Guilleloma/Tamagochi/hardware/case/view_front.png

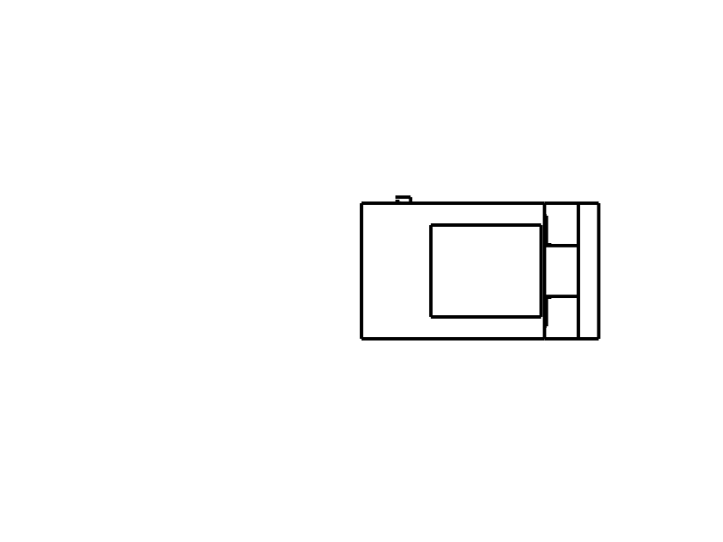
hardware/case/view_front.png
