Guilleloma/Tamagochi/hardware/case/view_isometric.png

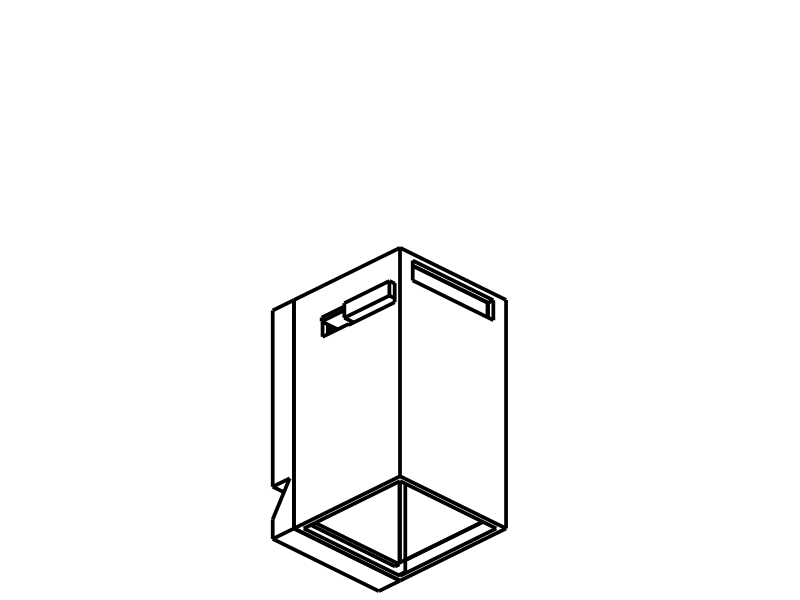
hardware/case/view_isometric.png
