Guilleloma/Tamagochi/hardware/case/view_side_minusX.png

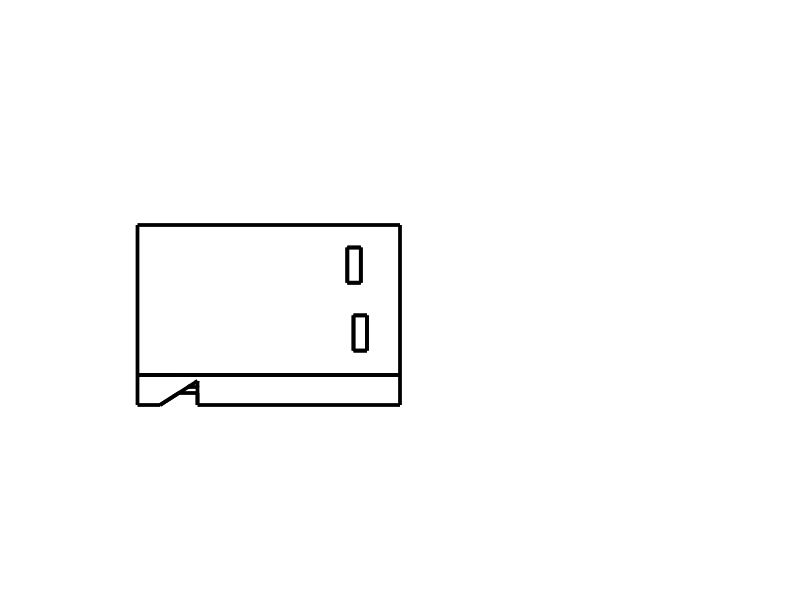
hardware/case/view_side_minusX.png
