Guilleloma/Tamagochi/hardware/case/stl/body-main.stl

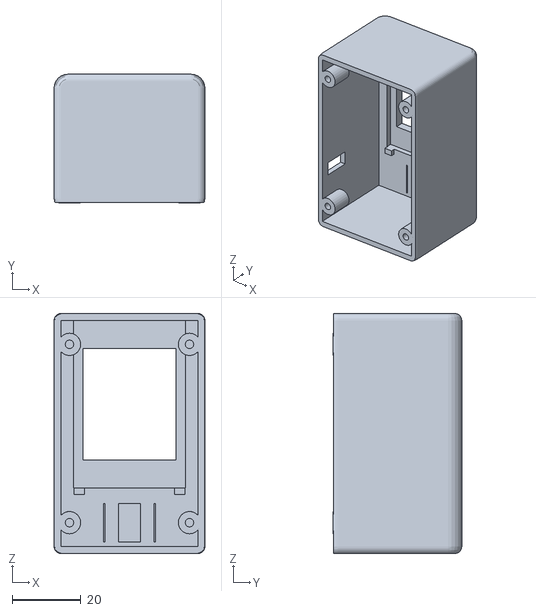
[picture p4: CAD file, 2026-06-21]
hardware/case/stl/body-main.stl
44.0 x 37.5 x 70.0
