Guilleloma/Tamagochi/hardware/case/stl/Tamagotchi.3mf

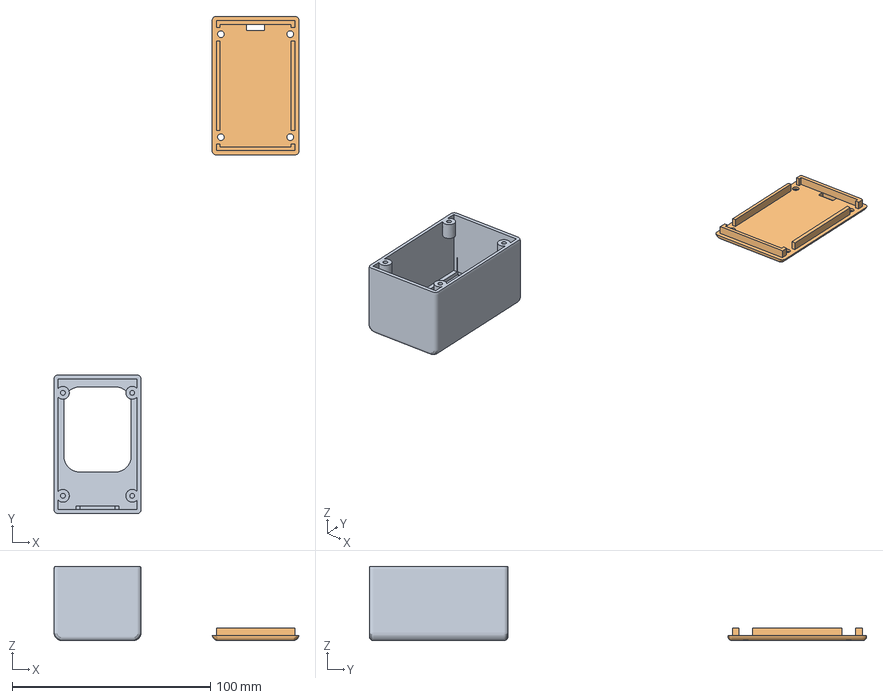
[picture p5: CAD file, 2026-07-13]
hardware/case/stl/Tamagotchi.3mf
123.7 x 251.1 x 37.5 mm
body-main.stl
rear-cover.stl
