Guilleloma/Tamagochi/hardware/case/tamagotchi-case.FCStd

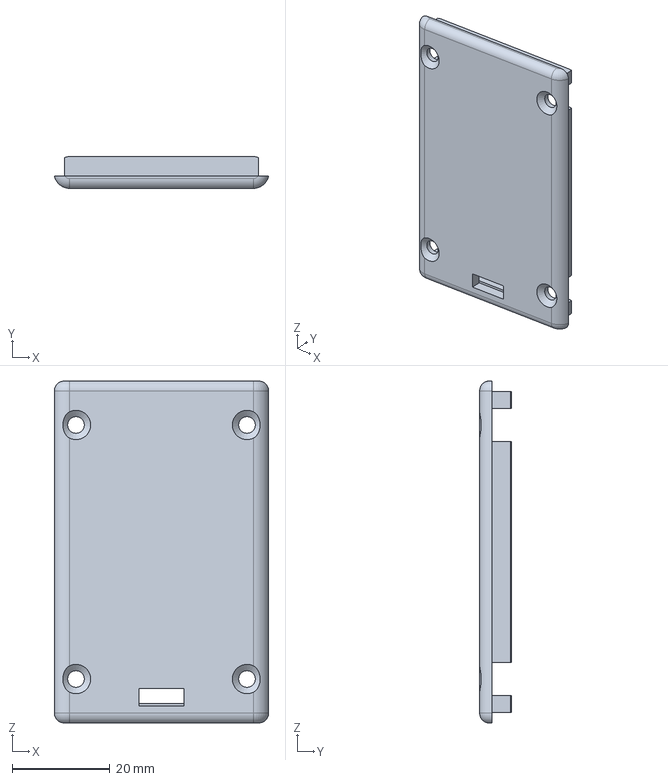
[picture p6: CAD file, 2026-07-13]
hardware/case/tamagotchi-case.FCStd
43.8 x 6.50 x 70.0 mm
