Guilleloma/Tamagochi/(list of files, cad)

Other CAD files:
hardware/case/stl/rear-cover.stl
