Guilleloma/Tamagochi/(commit log)

2026-05-26 Feature: Fase 0 bring-up — OLED + botón GPIO0 + FPS counter
    Scaffolding inicial del firmware Tamagochi para ideaspark ESP8266:
    - PlatformIO env esp12e, framework Arduino, libs U8g2 + OneButton, LittleFS declarado
    - include/config.h con pines OLED (GPIO4/5) y botón (GPIO0) y timings de render
    - src/main.cpp: sketch mínimo con OLED hello, sprite 32x32 animado y log de eventos del botón
    - FPS counter cada 5s para validar budget de render (objetivo >=5 FPS)
    - README con instrucciones de flasheo
    Verificado: pio run OK (RAM 37.3%, Flash 26.9%), pio check sin findings reales.
2026-05-26 Fix: bajar upload_speed a 460800 para CH340G vía hub USB
    El upload a 921600 fallaba con "Invalid head of packet (0xE0)" en setups con
    hub USB intermedio. 460800 es estable y mantiene un upload time razonable
    (~5s para el firmware Fase 0).
    Validado en hardware: flasheo OK, OLED inicializado en GPIO4/5, FPS=5.00 exacto.
2026-05-26 Fix: OLED de ideaspark V3.2 va por SW I2C en GPIO14/12, no HW I2C en GPIO4/5
    La revisión V3.2 de la placa cablea el SSD1306 a GPIO14 (clock) y GPIO12 (data)
    con bit-banging, no a los pines hardware I2C estándar del ESP8266. La guía oficial
    del fabricante lo confirma con el constructor U8G2_SSD1306_128X64_NONAME_F_SW_I2C.
    Síntoma con HW I2C: u8g2.begin() retornaba true (no verifica display real),
    renderFrame() corría a 5 FPS perfectos, pero el OLED mostraba congelado el demo
    de fábrica al no recibir nada por GPIO4/5.
    Cambios:
    - include/config.h: OLED_SDA=12, OLED_SCL=14
    - src/main.cpp: constructor SW_I2C, eliminado Wire.h y Wire.begin()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
    [config.h, main.cpp]
2026-05-26 Docs: actualizar README con resultados verificados de Fase 0 en hardware
    - Pines OLED reales: SW I2C en GPIO12/14 (no HW I2C en GPIO4/5)
    - Upload speed estable confirmado: 460800 baud vía hub USB
    - Estado Fase 0: verificado en hardware el 2026-05-26 con FPS 5.00 estable
    y eventos de botón (click corto + pulsación larga) confirmados por serie
2026-05-26 Docs: planificación Fase 1 + pipeline de sprites
    Artefactos de planificación previos a la implementación:
    - docs/fase-1-plan.md: plan detallado de implementación (StatsEngine,
    EventBus, Logger, Persistence LittleFS rotativa, OTA con password,
    tests host-native, hitos por commits atómicos) — 1215 líneas
    - docs/sprites-plan.md: inventario completo de sprites, layout OLED,
    pipeline PNG → PROGMEM, diferenciación visual entre etapas
    - tools/png_to_xbm.py: convierte PNGs monocromos a arrays C en PROGMEM
    compatibles con U8g2 drawXBMP() (LSB first, XBM estándar)
    - assets/sprites/: carpeta destino para los PNGs (con .gitkeep)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
2026-05-26 Feature: Logger + EventBus — base de Fase 1
    Hito 1 del plan docs/fase-1-plan.md:
    - lib/core/Logger/Logger.h: header-only, macros LOG_ERROR/WARN/INFO/DEBUG con
    LOG_LEVEL configurable (default 3=INFO). Compila para target (Serial.printf)
    y para env native (printf stdout) — base para tests host-native en hito 2
    - lib/core/EventBus/EventBus.{h,cpp}: pub/sub síncrono con function pointers
    planos (no std::function), arrays estáticos sin allocación dinámica,
    kMaxSubscribersPerEvent=4, ~55 bytes RAM. Sin Arduino.h, testeable en host.
    11 EventTypes definidos (button + stats + ota events).
    Build verificado: RAM 37.2% (sin cambio), Flash 26.7% (sin cambio) — Logger es
    header-only y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
2026-05-26 Test: env native con Unity para tests host-native
    Hito 2 del plan docs/fase-1-plan.md:
    - platformio.ini: añadido [env:native] con platform=native, test_framework=unity,
    -std=c++17, -DUNIT_TEST, -DLOG_LEVEL=0. build_src_filter excluye main.cpp y
    módulos dependientes de Arduino (OTAManager, InputHandler, DisplayRenderer,
    LittleFsStorage). [env:esp12e] intacto.
    - test/test_smoke/test_smoke.cpp: smoke test perpetuo que verifica que Unity
    y el entorno native arrancan correctamente. 1 test trivial, ~30 líneas.
    Verificado:
    - pio run -e esp12e: SUCCESS, RAM 37.2%, Flash 26.7% (sin cambio)
    - pio test -e native: 1 Tests 0 Failures 0 Ignored
    Habilita los tests host-native que escribirán l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
2026-05-26 Feature: Persistence LittleFS rotativo con CRC32 + 17 tests host
    Hito 3 del plan docs/fase-1-plan.md (secciones 3.4, 4, 5, 9.2, 9.3).
    Producción:
    - lib/domain/Persistence/Persistence.{h,cpp}: lógica pura (sin Arduino),
    struct PersistedState de 28 bytes con static_assert, CRC32 IEEE table-less,
    load() con escaneo de 4 slots + desempate por lastSavedAtEpoch/ageMinutes,
    save() atómico (escribe → fsync → borra slot k-3), migrate() con política
    de "muerte digna" para versiones incompatibles
    - lib/domain/Persistence/LittleFsStorage.{h,cpp}: IStorage sobre LittleFS,
    guarda #ifndef UNIT_TEST como defensa en profundidad ante cambios de
    build_src_filter
    Tests host (17, todos los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
2026-05-26 Feature: StatsEngine con decay fraccional + 14 tests host
    Hito 4 del plan docs/fase-1-plan.md (secciones 3.3 y 9.2).
    - lib/domain/StatsEngine/StatsEngine.{h,cpp}: lógica pura sin Arduino,
    stats (hunger/happiness/health) con decay fraccional vía acumuladores
    float, clamp a [0,100], dt clampeado a 24h max (evita overflow tras
    meses offline), health decay condicional (solo si hunger>=90 o
    happiness<=10), acumuladores reseteados al aplicar acciones para evitar
    doble descuento, dirty flag para integrar con EventBus.
    Tests host (14, todos los del plan sección 9.2):
    - test/test_stats_engine/test_stats_engine.cpp: defaults, dt=0 noop,
    decay 1s, clamp 0/100, dt huge clam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
2026-05-26 Refactor: extraer DisplayRenderer e InputHandler de main.cpp
    Hito 5 del plan docs/fase-1-plan.md (secciones 3.6 y 3.7).
    Refactor transparente: el comportamiento visible es idéntico a Fase 0
    (mismo texto en OLED, misma animación 32×32, mismos logs serie). Solo
    reorganización del código en preparación para hitos 6-7.
    Módulos nuevos:
    - lib/ui/InputHandler/{h,cpp}: wrapper de OneButton, recibe EventBus por
    constructor pero NO publica eventos aún (TODO(hito-6) documentado).
    Callbacks siguen haciendo Serial.println con los textos de Fase 0.
    - lib/ui/DisplayRenderer/{h,cpp}: renderer con scenes (IdleMain, StatsView,
    OtaProgress). En este hito solo IdleMain implementa el contenido re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
2026-05-26 Feature: EventBus integrado en main + StatsEngine vivo + StatsView real
    Hito 6 del plan docs/fase-1-plan.md (sección 7 — loop principal, parte
    aplicable a hito 6 sin Persistence/OTA).
    Primer hito con comportamiento nuevo visible para el usuario:
    - Click corto → toggle scene IdleMain ↔ StatsView (real, con valores)
    - Pulsación larga (>600ms) → applyFeed(20), hunger baja en tiempo real
    - StatsEngine tickea a 1Hz aplicando decay (visible tras minutos)
    InputHandler.cpp:
    - Callbacks publican al EventBus (ButtonShortClick/Double/LongPress)
    - LOG_INFO con prefijo [BTN] para trazabilidad por serie
    - Eliminados Serial.println literales (reemplazados por Logger)
    - setClickMs(150) + setPres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
2026-05-26 Fix: calibración del botón GPIO0 — click corto responsivo
    Iteración sobre el InputHandler tras hito 6 para resolver:
    - Click corto se sentía lento (~400ms de lag por espera de doble click)
    - Toques rápidos del usuario no se detectaban
    Cambios respecto a d1d3b22:
    - Eliminado attachDoubleClick (el evento ButtonDoubleClick está reservado
    para hitos futuros, ningún handler lo escucha en Fase 1). Sin doble click
    registrado, OneButton dispara attachClick instantáneamente tras soltar.
    - setClickMs reducido a 80ms (era 150ms)
    - setDebounceMs reducido a 40ms (era 75ms inicial intermedio): es el sweet
    spot que captura toques rápidos sin contar rebotes mecánicos del switch
    como cli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
2026-05-26 Feature: sprites Fase 1 (BABY + overlays) generados via Nano Banana
    - 8 loops procesados a 1-bit XBM para OLED 128x64:
    BabyIdle/Happy/Sad/Eat (32x32) + Overlay SleepZ/Hungry/Sick/Poop (16x16)
    - include/sprites_generated.h: 16 arrays PROGMEM, 1472 bytes totales
    - tools/slice_sheet.py: slicer de sprite sheets horizontales con
    trim de marcos perimetrales, flags --single y --preserve-position
    - .gitignore: excluir .venv-tools/ y assets/sprites/raw/ (regenerables)
2026-05-26 Feature: Persistence integrada en main (load al boot, save 5min + on-action)
    - config.h: añade PERSIST_AUTOSAVE_MS (5 min wall-clock, sin escalar con TURBO_MODE)
    - main.cpp: LittleFsStorage + Persistence singletons; helpers fillFromEngine/applyToEngine/loadResultName
    - setup(): monta LittleFS con fallback format, carga slot persistido y aplica al engine
    - loop(): scheduler de autosave cada 5 min vía PersistRequested
    - onLongPress(): publica PersistRequested tras feed (on-action save)
    - onPersistRequested(): serializa estado vivo y escribe en el slot rotativo
    - No se tocó lib/ui/DisplayRenderer/, assets/sprites/ ni sprites_generated.h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
2026-05-26 Feature: bebé BABY visible — sprite escalado, colores invertidos, portrait
    Integración visual del primer sprite real del Tamagochi (BABY idle).
    Validado en hardware con Guillermo: el bebé blanco animado se ve nítido
    ocupando el ancho completo de la pantalla portrait.
    tools/png_to_xbm.py:
    - Nuevo flag --invert que mapea pixel negro → bit=1 (encendido en OLED).
    Necesario porque los PNGs originales vienen con fondo blanco/sujeto negro
    y el OLED rinde el OPUESTO: fondo apagado/sujeto encendido.
    include/sprites_generated.h:
    - Regenerado con --invert: todos los sprites (BABY + overlays) ahora con
    polaridad correcta para el OLED.
    lib/ui/DisplayRenderer/DisplayRenderer.cpp:
    - Elimin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
    [main.cpp]
2026-05-26 Docs: README actualizado para Fase 1 completada
    Hito 9 del plan docs/fase-1-plan.md.
    README.md:
    - Reemplazado estado "Fase 0 (Bring-up)" por tabla de features Fase 1
    - Sección "Cómo se juega" con la mecánica del botón corto/largo + tempo
    - Detalle de hardware actualizado (SW I2C en GPIO12/14, U8G2_R1 portrait)
    - Estructura del proyecto (lib/core/domain/ui)
    - Sección "Verificación de Fase 1" con tests + endurance opcional 24h
    - Roadmap Fase 2-4 + OTA diferido (decisión del usuario)
    include/config.h:
    - Comentario obsoleto "sprite dummy" → "sprite BABY" (los sprites reales
    ya están integrados desde el commit 5d37bb4)
2026-05-26 Docs: plan detallado Fase 2 (1239 líneas, 10 hitos)
    Plan vinculante para backend-expert con la arquitectura completa de Fase 2:
    etapas de vida (EGG→BABY→KID→ADULT→OLD→DEAD), LifeFSM, StatsEngine
    extendido (discipline/weight/poop/sick/sleeping), schema v2 con migrate
    v1→v2, TURBO_MODE con guards anti-producción, animaciones HAPPY/SAD/EAT,
    muerte y resurrección automática.
    Decisiones clave resueltas:
    - Sprites faltantes (no-BABY): BABY como placeholder global, no bloquea
    desarrollo. Sustituciones se hacen por hito intercalado cuando Guillermo
    entregue los PNGs.
    - Schema v2: 40 bytes, migrate v1→v2 con defaults coherentes para los 12
    campos nuevos. Sin romper estados gu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
2026-05-26 Feature: PersistedState v2 — schema 40 bytes + migrate v1→v2
    Hito 1 de Fase 2 (docs/fase-2-plan.md sección 3).
    Persistence:
    - struct PersistedState extendido de 28 → 40 bytes con 12 campos nuevos
    (discipline, weight, poopCount, flags=sick/sleeping, attentionScore,
    deathSustainMs, lastDeathCauseCode, adultType, reservedV2b) + crc32
    movido a offset 36
    - enum LifeStage { Egg=0, Baby=1, Kid=2, Adult=3, Old=4, Dead=5 }
    - kCurrentVersion bumpeada a 2
    - fillDefaults arranca con Egg (huevo nuevo) en lugar de Baby
    - migrate(): dispatch a migrate_v1_to_v2_() según versión leída
    - migrate_v1_to_v2_(): preserva campos v1 (hunger/happ/health/...) y
    rellena los v2 con defaults (discipli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
2026-05-26 Docs: actualizar plan Fase 2 — adultType en lugar de reservedV2
    El byte [33] del PersistedState v2 se usa como adultType (0=normal,
    1=athletic, 2=obese, 3=grumpy) en lugar de reservedV2 (padding).
    La sección 6 del plan ya anticipaba esta decisión; este commit alinea
    la sección 3.1 y 3.3 con la convención adoptada en el hito 1 (331967b).
    Sin cambios funcionales — solo coherencia documental.
2026-05-26 Feature: StatsEngine extendido — discipline/weight/poop/sick/sleeping + 18 tests
    Hito 2 de Fase 2 (docs/fase-2-plan.md sección 4).
    StatsEngine.h:
    - Stats v2 con 5 campos nuevos (discipline=50, weight=50, poopCount=0,
    isSick=false, isSleeping=false, attentionScore=500)
    - DecayRates v2 con 6 ratios nuevos (weight metabolism, discipline,
    poop spawn prob, sickness prob, sick health multiplier)
    - 4 acciones nuevas: applyClean, applyMedicate, applyDiscipline, applySleep
    - resetForNewLife() para huevos nuevos
    - RNG inyectable vía setRandomSource() — function pointer plano, sin
    std::function. Permite tests deterministas con secuencias controladas.
    - kMaxPoopCount = 9
    StatsEngine.cpp:
    -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
2026-05-26 Feature: LifeFSM — 6 etapas de vida + transiciones automáticas + 16 tests
    Hito 3 de Fase 2 (docs/fase-2-plan.md sección 5).
    Nuevo módulo lib/domain/LifeFSM:
    - enum AdultType { Normal=0, Athletic=1, Obese=2, Grumpy=3 }
    - 7 constantes de transición: kEggHatchMin=5, kBabyToKidMin=60,
    kKidToAdultMin=240, kAdultToOldMin=720, kOldToDeadMin=1440,
    kDeathSustainMs=60000, kResurrectionMs=300000
    - tick(dt, stats, attention): consume StatsTick + lee stats const-ref
    para decidir transiciones
    - Egg ignora muerte (huevos no mueren por health)
    - Death sustain con saturating_add a kDeathSustainMs
    - Egg→Baby tras ageMinutes>=5
    - Baby→Kid bloqueada por attentionScore<300, forzada a 1.5×kBabyT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
2026-05-26 Feature: TURBO_MODE — ciclo de vida ×60 para testing
    Hito 4 de Fase 2 (docs/fase-2-plan.md sección 8).
    Permite vivir el ciclo Egg→Baby→Kid→Adult→Old→Dead→Egg completo en
    menos de 1 hora real en lugar de 25h. Solo para desarrollo y QA.
    platformio.ini:
    - Nuevo env esp12e_turbo que extiende esp12e + flags -D TURBO_MODE
    -D TURBO_FACTOR=60. El env por defecto (esp12e) NO lleva TURBO.
    - FIRMWARE_VERSION condicional: 0x0200 (prod) / 0x02FE (turbo).
    El sufijo 0xFE marca "build de desarrollo, no producción".
    - LIFE_FSM_TIME_SCALE: 1 (prod) / TURBO_FACTOR=60 (turbo).
    lib/domain/LifeFSM/LifeFSM.cpp:
    - Fallback inline de LIFE_FSM_TIME_SCALE (sin incluir config.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
2026-05-26 Feature: DisplayRenderer multi-sprite por etapa + DeadScreen + banner TURBO
    Hito 5 de Fase 2 (docs/fase-2-plan.md sección 6).
    DisplayRenderer.h:
    - enum class Mood { Idle, Happy, Sad, Eat }
    - Scene::DeadScreen añadida
    - API nueva: setLifeStage, setAdultType, setLastDeathCause,
    setAgeMinutes, setDeathCount, triggerEatAnimation
    - Privados: lifeStage_, adultType_, lastDeathCause_, ageMinutes_,
    deathCount_, eatAnimRemainingMs_, computeMood_(), drawDeadScreen_(),
    drawTurboBanner_() bajo #ifdef TURBO_MODE
    DisplayRenderer.cpp:
    - struct SpriteFrames { frames[3], frameCount } para centralizar
    animaciones de 1, 2 o 3 frames
    - Tabla kSpritesByStage[6][4] (LifeStage x Mood): fila BABY con
    s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
2026-05-26 Feature: overlays asíncronos sobre sprite — sleep/sick/hungry/poop
    Hito 6 de Fase 2 (docs/fase-2-plan.md sección 6.4).
    DisplayRenderer.cpp añade drawOverlays_() llamado desde drawIdleMain_
    justo antes de sendBuffer(). Pinta encima del sprite del personaje
    según el estado vivo de stats_:
    - Sick (calavera 16x16 en x=4, y=4): cuando isSick=true
    - SleepingZ (animado 800ms): cuando isSleeping. Posición x=42 normal,
    se desplaza a x=24 si Sick también está activo (evita solape).
    - Hungry (gota parpadeante 600ms): cuando hunger>=80 && !isSleeping.
    En x=48, y=68 (debajo del sprite, esquina derecha).
    - Poop (caca 16x16, hasta 3 visibles): cuando poopCount>0. En y=110
    (zona inferior li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
2026-05-27 Feature: cablear LifeFSM + DeadScreen + EAT animation en main (hitos 7-9)
    Integración completa de Fase 2 en src/main.cpp. Fusiona los hitos 7
    (muerte y resurrección), 8 (animación EAT one-shot) y 9 (cableado
    LifeFSM + persist en transiciones) en un commit coherente porque
    todos modifican el mismo archivo y dependen entre sí.
    Singletons nuevos:
    - LifeFSM lifeFSM(bus) construido tras StatsEngine
    - previousStage_ static para detectar resurrección Dead → Egg
    Helpers actualizados a schema v2:
    - applyToStatsEngine reemplaza applyToEngine: lee todos los 9 campos
    v2 desde PersistedState (incluye discipline, weight, poopCount, flags
    bit-packed, attentionScore)
    - fillFromEngine ahora toma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
2026-05-27 Polish: mini-contador edad + ortografía "Tamagotchi"
    Pulido visual de Fase 2 tras validación en hardware con Guillermo.
    - Mini-contador de edad debajo del título en IdleMain. Formato compacto:
    "9m" si <60 min, "1h2m" si >=60 min, cap a 99h para caber en 64px.
    Fuente 6x10 (igual que título) por legibilidad — el 4x6 inicial era
    ilegible en hardware según feedback. Posición (0, 100) bajo "Tamagotchi"
    en y=85, sin solape.
    - Fix ortografía: "Tamagochi" → "Tamagotchi" (marca correcta, con T).
    10 chars × 6 px = 60 px, recentrado en x=2 (cabe justo en 64 wide).
    src/main.cpp:
    - Tras lifeFSM.tick() en cada stats tick, llamada a
    renderer.setAgeMinutes(life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
    [main.cpp]
2026-05-27 Docs: README actualizado para Fase 2 completada
    Hito 10 del plan docs/fase-2-plan.md.
    - Título corregido "Tamagochi" → "Tamagotchi" (marca con T)
    - Descripción actualizada con ciclo de vida completo
    - Sección "Cómo se juega" extendida: 6 etapas, animaciones, overlays
    asíncronos, mini-contador edad, DeadScreen, resurrección
    - Tabla de estado por capa con 13 features verificadas + 4 diferidas
    - Comandos PlatformIO incluyen env esp12e_turbo
    - Estructura del proyecto refleja LifeFSM y tests v2
    - Sección "Verificación de Fase 2" con tests + endurance opcional
    - Pipeline de sprites documentado (slice_sheet.py + png_to_xbm.py --invert)
    - Roadmap actualizado: Fase 2.5 (sprite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
2026-05-27 Assets+Feature: sprites EGG (4 frames) generados e integrados
    Primer batch de sprites no-BABY de Fase 2.5. El huevo es ahora visible
    en pantalla cuando lifeStage_ == Egg (al primer boot sin estado guardado,
    o tras resurrección Dead → Egg).
    assets/sprites/egg_0..3.png:
    - Generados por el otro dev con Nano Banana + slice_sheet.py
    - 4 frames: quieto, leve vibración, vibración fuerte, grieta
    - 32×32 monocromo, fondo blanco / sujeto negro
    - Regenerado con tools/png_to_xbm.py --invert
    - Añadidos kSpriteEgg0..3 (32x32 cada uno, 128 bytes PROGMEM × 4 = 512B)
    - kSpritesByStage[Egg][] ya no usa kSpriteBabyIdle como pla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
2026-05-27 Feature: animaciones de transición + tabla Egg sin moods + fix colores
    Pulido visual tras validación con Guillermo del primer ciclo de vida.
    DisplayRenderer:
    - triggerHatchAnimation() one-shot 2.4s: cuando Egg→Baby, muestra
    frames 2-3 del huevo (vibración + grieta) con texto "Eclosion"
    antes de revelar el bebé. Visualiza la eclosión.
    - triggerEvolveAnimation() one-shot 1.2s: cuando Baby→Kid, Kid→Adult,
    Adult→Old, parpadea el sprite (alterna visible/oculto cada 200ms)
    para señalar el cambio de etapa.
    - Tabla kSpritesByStage[Egg]: todos los moods usan frames 0+1 idle
    (el huevo no tiene moods narrativos). Frames 2-3 reservados para
    la animación de eclosión.
    - Forwar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
    [main.cpp]
2026-05-27 Assets+Feature: sprites KID/ADULT/OLD/DEAD integrados
    Resto de etapas de vida con arte real. Genera el ciclo visual completo
    del Tamagotchi clásico: Egg → Baby → Kid → Adult → Old → Dead → Egg.
    Sprites nuevos (16 PNGs en assets/sprites/):
    - kid_idle_0/1 + kid_happy_0/1/2 + kid_sad_0/1
    - adult_idle_0/1 + adult_happy_0/1/2
    - old_idle_0/1
    - dead_ghost_0/1
    - Nuevos arrays: kSpriteKidIdle0/1, kSpriteKidHappy0/1/2, kSpriteKidSad0/1,
    kSpriteAdultIdle0/1, kSpriteAdultHappy0/1/2, kSpriteOldIdle0/1,
    kSpriteDeadGhost0/1
    lib/ui/DisplayRenderer/DisplayRenderer.cpp tabla kSpritesByStage:
    - Kid (2): idle/happy/sa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
2026-05-27 Assets+Feature: sprites EAT para Kid/Adult/Old (9 PNGs, 3 frames cada uno)
    Cada etapa de vida tiene ahora su propia animación de comer.
    Antes, todas las etapas no-Baby usaban fallback idle al alimentar
    (long press en hardware) — visualmente no había diferencia.
    Assets nuevos:
    - kid_eat_0/1/2.png (niño comiendo, 3 frames)
    - adult_eat_0/1/2.png (adulto comiendo, 3 frames)
    - old_eat_0/1/2.png (anciano comiendo, 3 frames)
    include/sprites_generated.h regenerado con --invert:
    - kSpriteKidEat0/1/2, kSpriteAdultEat0/1/2, kSpriteOldEat0/1/2
    - Kid[Eat] → kSpriteKidEat0/1/2 (era fallback kSpriteKidIdle)
    - Adult[Eat] → kSpri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
2026-05-27 Docs: cierre Fase 2.5 — sprites completos + backlog claro
    - Fase 2.5 marcada como completada en el roadmap
    - Backlog específico para no perder pendientes:
    · applyPlay (única acción Tamagotchi clásico no implementada)
    · ActionMenu en pantalla (navegación con 1 botón)
    · Sprites faltantes Adult sad, Old happy/sad (baja prioridad)
    · AdultType variants (athletic/obese/grumpy)
    - Mención explícita "jugar" en Fase 3 (web UI) además de limpiar/curar/etc
    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
2026-05-27 Feature: applyPlay con coste energético + guard isSleeping
    La acción "jugar" ya existía pero era minimalista (solo subía happiness,
    sin coste, sin restricciones). Ampliada para reflejar la mecánica del
    Tamagotchi clásico:
    - Coste energético: hunger += amount/2 al jugar (jugar quema energía
    y abre el apetito). applyPlay(20) sube happiness +20 Y hunger +10.
    - Guard isSleeping: si el Tamagotchi está dormido, applyPlay es no-op
    con LOG_DEBUG. Consistente con applyFeed.
    - Acumuladores hungerAcc_ y happinessAcc_ reseteados para evitar doble
    descuento en el siguiente tick.
    Tests nuevos (2, total 73):
    - test_play_also_increases_hunger: verifica que play(20) sube hunger
    en 10 adem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
2026-05-27 Docs: plan detallado Fase 3 (1300 líneas, 9 hitos)
    Plan vinculante para backend-expert con la arquitectura completa de
    la Web UI WiFi: AsyncWebServer + REST /api/v1/* + HTML/CSS/JS desde
    LittleFS + WiFi STA con secrets.h gitignored + OTA con password + auth
    básica + rate limiting + indicador WiFi en OLED.
    Decisiones críticas resueltas:
    - ESPAsyncWebServer (async, no bloquea loop) vs sync
    - secrets.h gitignored extendido (WIFI_SSID/PASSWORD + WEB_AUTH_USER/PASS
    + OTA_HOSTNAME/PASSWORD)
    - WiFi degradación graceful: 0ms bloqueo setup, reintentos background
    - HTTP Basic Auth (no OAuth) sobre LAN trust
    - Rate limit token bucket 10/600ms, 4 IPs LRU
    - ArduinoJson v7 con JsonDocument en stack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
2026-05-27 Feature: WifiManager + secrets.h gitignored + indicador WiFi en OLED
    Hito 1 de Fase 3 (docs/fase-3-plan.md sección 1-2, 6, 7).
    Infraestructura WiFi mínima sin bloquear el loop:
    include/secrets.h.example (versionado):
    - Template con WIFI_SSID/PASSWORD, OTA_HOSTNAME/PASSWORD,
    WEB_AUTH_USER/PASSWORD. Strings vacíos = feature deshabilitada.
    - El usuario copia a include/secrets.h (gitignored) y rellena.
    .gitignore:
    - Añadida línea explícita "include/secrets.h" para garantizar que
    el archivo con credenciales reales nunca se commitee.
    lib/infra/WifiManager/:
    - Estados: Disabled (SSID vacío), Connecting, Connected, Disconnected
    - begin() no bloquea — sólo llama WiFi.begin() y arran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
2026-05-27 Feature: OTAManager + mDNS + env esp12e_ota para flasheo por aire
    Hito 2 de Fase 3 (docs/fase-3-plan.md sección 8).
    El firmware ya se puede actualizar SIN cable USB desde el Mac.
    lib/infra/OTAManager/:
    - Singleton-via-instance para callbacks C de ArduinoOTA (mismo patrón
    que InputHandler con OneButton). Evita std::function overhead.
    - begin() solo arranca si OTA_PASSWORD no está vacío. Si vacío, LOG_WARN
    y queda en estado "no ready" sin error.
    - Hostname y port (8266) desde secrets.h
    - Callbacks publican OtaStarted/OtaProgress/OtaEnded/OtaError al bus
    - end() solo desmarca ready_ (ArduinoOTA.end() no existe en el SDK)
    lib/core/EventBus/EventBus.h:
    - OtaFinished renombrado a OtaEn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
    [main.cpp]
2026-05-27 Feature: JsonCodec + PayloadValidator + 20 tests host
    Hito 3 de Fase 3 (docs/fase-3-plan.md secciones 4 y 9.1-9.2).
    Capas puras de serialización/validación, sin Arduino.h, testeables
    en host-native con Unity. Preparan el terreno para los endpoints
    REST que añadirá el hito 5.
    lib/infra/WebUI/JsonCodec.{h,cpp}:
    - Namespace JsonCodec (no clase) con funciones libres
    - serializeState(stats, stage, ageMin, deathCount, turbo, out, outSize)
    → {data: {...}, meta: {apiVersion, timestamp}}
    - serializeInfo(version, uptime, freeHeap, rssi, out, outSize)
    - serializeActionResponse(...) con actionApplied
    - serializeError(code, message, out, outSize) — formato estándar
    {error: {code, message}}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
2026-05-27 Feature: RateLimiter + AuthChecker + 15 tests host
    Hito 4 de Fase 3 (docs/fase-3-plan.md secciones 1.5, 1.6, 9.3, 9.4).
    Capas puras de seguridad y throttling para los endpoints REST.
    Ambas testeables en host-native sin Arduino.h.
    lib/infra/WebUI/RateLimiter.{h,cpp}:
    - Token bucket por IP, capacidad 10 tokens, refill 1/600ms
    - Array fijo IpBucket[kMaxTrackedClients=4], sin malloc
    - LRU eviction cuando se acuserve un 5º IP — slot más antiguo se reasigna
    - allow(clientIp, nowMs) → true si permite, false si rate-limited
    - Tiempo inyectado vía parámetro nowMs (no llama millis() — testeable)
    - Refill drift-free: lastRefillMs += addTokens × interval (no reset a now)
    - Defensive contra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
2026-05-27 Fix: invertir polaridad de sprites OLED (silueta ON, fondo OFF)
    Los PNGs en assets/sprites/ se dibujan con fondo blanco + silueta negra,
    pero el generador png_to_xbm.py mapeaba "pixel blanco -> bit=1 (ON)" por
    defecto, lo que dejaba el FONDO encendido y la silueta apagada en el OLED
    SSD1306. En la placa se veía la silueta oscura sobre fondo claro.
    - tools/png_to_xbm.py: invertir el default. Ahora "pixel negro -> bit=1".
    El flag pasa de --invert a --raw para el caso opuesto (PNGs ya en
    convencion XBM estandar). Docstring actualizado.
    - include/sprites_generated.h: regenerado entero con la nueva polaridad
    (silueta encendida, fondo apagado). Afecta a sprites de personaje
    (32x32) y ove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
2026-05-27 Feature: WebUI AsyncWebServer + GET /api/v1/state e /info
    Hito 5 de Fase 3 (docs/fase-3-plan.md secciones 3.1-3.2, 4.1-4.4, 4.6).
    Primera versión funcional del servidor HTTP del Tamagochi.
    Validado en hardware: curl -u admin:xxx http://tamagotchi.local/api/v1/state
    devuelve JSON 200 con todos los stats; auth incorrecta → 401.
    lib/infra/WebUI/WebUI.{h,cpp}:
    - Clase WebUI con AsyncWebServer en puerto 80
    - Constructor toma const refs a EventBus, StatsEngine, LifeFSM, WifiManager
    (solo lectura; no llama directamente al dominio, futuras acciones
    pasarán por EventBus en hito 6)
    - begin()/end() idempotentes; arrancar solo con WiFi conectado
    - mountRoutes_(): registra GET /api/v1/state, GE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
2026-05-27 Feature: 7 endpoints POST para acciones del Tamagochi vía REST
    Hito 6 de Fase 3 (docs/fase-3-plan.md secciones 4.3-4.5, 4.7).
    Por primera vez el móvil puede EJECUTAR acciones del Tamagochi vía
    HTTP. Antes solo se podía leer (GET); ahora se puede actuar (POST).
    - 7 EventType nuevos (antes de EventTypeCount):
    ActionFeedRequested, ActionPlayRequested, ActionHealRequested,
    ActionCleanRequested, ActionMedicateRequested,
    ActionDisciplineRequested, ActionSleepRequested
    - Payload semántica: amount (1-100) para feed/play/heal/discipline,
    0 para clean/medicate, 0/1 para sleep off/on
    lib/infra/WebUI/{h,cpp}:
    - 7 handlers privados (5 con JsonVariant body, 2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
2026-05-27 Feature: frontend HTML/CSS/JS en data/ + serveStatic en WebUI
    Hito 7 de Fase 3 (docs/fase-3-plan.md sección 5).
    El móvil ya tiene una UI completa para gestionar el Tamagotchi sin
    curl. Tras flashear firmware + subir LittleFS, abrir
    http://tamagotchi.local desde cualquier navegador en la LAN.
    data/index.html (~3.6 KB):
    - Layout mobile-first portrait, HTML5 semántico
    - Header: título "Tamagotchi" + badge Online/Offline
    - Sección mascota: emoji grande según lifeStage (🥚🐣👶👦🧑👴💀)
    con bounce CSS sutil, stage + edad
    - Badges inline: 🤧 Sick (rojo) y 💤 Sleeping (azul) cuando aplique
    - Stats: 4 barras de progreso (Hambre, Animo, Salud, Disciplina)
    + Peso/Caca deba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
2026-05-27 Test: script integracion HTTP scripts/integration_test.sh (27 tests)
    Hito 8 Fase 3: valida los 9 endpoints REST + frontend estatico contra
    un dispositivo real. Cubre auth (401), happy path por endpoint, errores
    de validacion (422), JSON malformado (400) y 404. Sin dependencias mas
    alla de curl + bash.
    Uso:
    HOST=192.168.x.x ./scripts/integration_test.sh
    HOST=tamagotchi.local ./scripts/integration_test.sh
    Resultado actual contra placa: 27 PASS / 0 FAIL.
2026-05-27 Docs: README actualizado a Fase 3 completada
    - Tabla "Estado actual" refleja WifiManager / OTAManager / WebUI /
    RateLimiter / AuthChecker / frontend LittleFS.
    - Test count actualizado de 71 a 108 host + 27 integracion HTTP.
    - Nueva seccion "Web UI - Fase 3" con tabla de endpoints, auth, rate
    limiting y como correr scripts/integration_test.sh.
    - Setup incluye uploadfs y flasheo OTA (env esp12e_ota).
    - Seccion "Secrets" documenta los campos de include/secrets.h y el
    comportamiento si quedan vacios.
    - Roadmap: Fase 3 marcada, Fase 4 sigue pendiente. Backlog actualizado
    (applyPlay eliminado — ya mergeado en main; reset y cosmetico sleep
    documentados).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
2026-05-27 Refactor: HUD top en IdleMain (edad izq, estado rotante, wifi der)
    El layout anterior repartía info por toda la pantalla: texto "Tamagotchi"
    debajo del sprite, edad en la esquina inf-izq, overlays sick/sleep/hungry/
    poop dispersos arriba y abajo. Quedaba abigarrado y sin zona libre para
    las acciones que llegan en próximas fases.
    Nuevo layout (64x128 portrait):
    HUD top (y=0..15): edad izq | estado rotante 16x16 centro | wifi der
    Personaje (y=16..79): sprite 32x32 escalado x2 -> 64x64
    Zona inferior (y=80..127, 48 px): libre para acciones futuras
    Cambios concretos:
    - drawIdleMain_: elimina texto "Tamagotchi", elimina edad inferior,
    sube sprite de y=4 a y=16, pinta edad arriba-izq en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
2026-05-27 Feature: ActionKind + listAvailableActions con precondiciones
    Introduce el enum ActionKind y la función listAvailableActions en
    StatsEngine para que la capa de UI pueda consultar qué acciones físicas
    están disponibles según el estado actual del Tamagochi, sin acoplar
    lógica de negocio al dispatcher ni al renderer. El dispositivo deja de
    ser subordinado pasivo del dashboard: tiene su propia lógica de qué
    acciones son válidas en cada momento.
2026-05-27 Feature: menú físico de acciones + StatsView densa (paridad físico/dashboard)
    Añade Scene::ActionsMenu al DisplayRenderer con cursor navegable,
    drawActionsMenu_ para renderizar la lista filtrada por precondiciones,
    y StatsView densa con 9 stats en pantalla. Refactoriza onShortClick y
    onLongPress en main.cpp con lógica contextual y helpers quickFeed_ /
    executeSelectedAction_. El dispositivo físico alcanza paridad funcional
    con el dashboard: el usuario puede ejecutar cualquier acción directamente
    desde los botones, sin depender de la interfaz web.
2026-05-27 Refactor: HUD inferior de acciones en IdleMain (sustituye ActionsMenu)
    El menú separado de acciones obligaba a abandonar la pantalla principal
    para seleccionar qué hacer, perdiendo de vista al bicho. Ahora el sprite
    y la acción seleccionada conviven en IdleMain: short click cicla la
    acción en el HUD, long press la ejecuta. Se elimina Scene::ActionsMenu
    y todo su renderizado asociado. ActionKind::Back pasa a ActionKind::Stats
    para reflejar su propósito real. La vista de stats recupera el foco con
    un simple short click desde ella.
    [main.cpp]
2026-05-27 Feature: iconos 16x16 en HUD inferior de acciones
    - Sustituye dots de paginacion + hint "long=OK" por icono pixel-art 16x16 por accion + label centrado.
    - Iconos generados con tools/generate_action_icons.py (pictogramas placeholder; sustituibles por arte definitivo).
    - 8 sprites nuevos: feed, play, clean, medicate, discipline, sleep, heal, stats.
    - Coste flash: +256 bytes (8 x 32 bytes XBM). Build OK, RAM 48.7%, Flash 41.3%.
2026-05-27 Feature: frames de animacion para acciones (Play/Clean/Disc/Heal)
    10 PNGs 16x16 monocromos generados por dev externo:
    - Play: 4 frames (action_play_0..3)
    - Clean: 2 frames (action_clean_0..1)
    - Discipline: 2 frames (action_discipline_0..1)
    - Heal: 2 frames (action_heal_0..1)
    Header sprites_generated.h regenerado con todas las constantes XBM nuevas.
2026-05-27 Feature: HUD horizontal compacto + sprite centrado + animaciones de accion
    - HUD inferior rediseñado en 1 fila (y=112..127): icono 16x16 + label 6x10
    en horizontal, liberando aire vertical respecto al layout anterior
    - Sprite del personaje centrado en y=32, con 16px de margen arriba y abajo
    entre el HUD superior y el HUD inferior
    - Nuevo mecanismo de animacion de sustitucion: drawXBMx4 renderiza frames
    ampliados x4, triggerActionAnimation reemplaza al sprite del muneco durante
    600ms x frameCount (1.2s Play/Clean/Disc/Heal con 2-4 frames)
    - Conectado en executeSelectedAction_ para Play, Clean, Discipline y Heal;
    Feed mantiene su animacion EAT clasica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
2026-05-27 Feature: sustituye boton FLASH por touch TTP223 en GPIO4
    PIN_BUTTON pasa de GPIO0 (FLASH onboard active-LOW con pull-up) a GPIO4
    (sensor capacitivo TTP223 active-HIGH push-pull). Se extiende la API de
    InputHandler con un nuevo parametro pullupActive (default true para no
    romper la firma existente) y se propaga al constructor de OneButton.
    La instanciacion en main.cpp pasa activeLow=false y pullupActive=false
    para reflejar la salida limpia del TTP223. Los timings de OneButton
    (click 80ms, debounce 40ms, longpress 600ms) se mantienen idénticos —
    los eventos publicados al EventBus son los mismos, sin cambios en la FSM.
2026-05-27 Docs: actualiza README con touch TTP223 como input principal
    La tabla de hardware refleja el TTP223 en GPIO4 (D2) en lugar del FLASH
    en GPIO0. Se reescribe la nota sobre comportamiento del boton: ya no hay
    rebote mecanico que justifique el rango 100-500 ms — el TTP223 entrega
    flanco limpio, asi que la nota describe directamente los umbrales de
    click corto vs. long press y el LED visual del modulo.
2026-05-27 Refactor: baja debounce del boton a 10 ms tras pasar a touch capacitivo
    El debounce de 40 ms era una concesion al rebote mecanico del FLASH onboard.
    El TTP223 entrega flanco limpio: 10 ms ya filtra cualquier ruido residual y
    reduce a la mitad la latencia percibida del click corto. setClickMs baja a
    30 ms por coherencia (sigue sin efecto practico al no haber doubleClick
    attach). setPressMs se mantiene en 600 ms — el umbral de long press no
    viene marcado por hardware sino por la intencion del usuario.
2026-06-18 Feature: ESP32-S3 env + JD9853 color display bring-up y SpriteStore (Fases 0-1)
    - platformio.ini: nuevo env esp32s3 con lib_deps (TFT_eSPI, LittleFS) y lib_ignore
    - src/bringup_esp32s3.cpp: sketch de bring-up, integración SpriteStore y canvas
    - lib/ui/SpriteStore/SpriteStore.h y .cpp: loader de sprites RGB565 desde LittleFS
2026-06-18 Feature: add wizard RGB565 sprite assets para LittleFS
    - data/sprites/manifest.json: índice de animaciones del mago
    - data/sprites/wiz/{eat,happy,playing,sick,sleep,walk}/*.bin: frames RGB565
    para carga directa en LittleFS del ESP32-S3
2026-06-18 Feature: extraer WifiState enum y definir DisplayRendererColor API (Fase 2)
    - lib/core/WifiState.h: enum WifiState extraído de WifiManager para romper dependencia circular
    - lib/infra/WifiManager/WifiManager.h: incluye WifiState.h en lugar de definir el enum inline
    - lib/ui/DisplayRendererColor/DisplayRendererColor.h: interfaz pública del renderer color para ESP32-S3 (TFT 240x280, paleta 16-bit)
2026-06-18 Feature: implementar DisplayRendererColor para TFT color ESP32-S3 (Fase 2)
    Implementación completa del renderer color: inicialización TFT via LGFX,
    doble buffer en PSRAM, renderizado de sprites monocromo con paleta de color,
    overlays de UI (barra de vida, indicadores de estado, menú), y primitivas
    de debug. Sustituye al DisplayRenderer monocromo de la placa original.
2026-06-18 Feature: loop de juego ESP32-S3 con panel JD9853, input y persistencia (Fases 3-4)
    - include/jd9853_panel.h: configuración compartida del panel TFT JD9853 (init cmds, timings)
    - src/main_esp32.cpp: entrypoint de producción ESP32-S3 con game loop real, input buttons,
    NVS persistence y watchdog
    - src/main_phase2.cpp: harness de desarrollo Fases 2-3 para validar renderer y WiFi por separado
    - include/config.h: botón GPIO condicional por plataforma + FIRMWARE_VERSION para ESP32-S3
    - platformio.ini: envs esp32s3 / esp32s3_turbo, lib_deps LGFX, build_src_filter por env
2026-06-19 Feature: catalogo de sprites Furbygotchi por etapa (egg/baby/kid/adult/old/ghost) en LittleFS
    Reemplaza el set wiz/ por 6 etapas de vida con sus animaciones .bin:
    egg(2), baby(23), kid(23), adult(23), old(23), ghost(6). Actualiza manifest.json.
2026-06-19 Feature: DisplayRenderer multi-etapa con precarga en PSRAM (Fase 6)
    Refactor a struct StageSprites y spritesByStage_; framesForMood_(stage,mood)
    resuelve frames por etapa/estado. Precarga de las 6 etapas en PSRAM al inicio.
    drawDeadScreen usa sprites ghost.
2026-06-19 Feature: animaciones one-shot de accion + render a 15 FPS (pulido Fase 6)
2026-06-19 Feature: WiFi + OTA + WebUI dashboard en ESP32-S3 (Fase 5)
2026-06-19 Refactor: eliminar harnesses de desarrollo (bringup, main_phase2) para main estable
2026-06-19 Docs: documentar variante ESP32-S3 color (Furbygotchi) en README
2026-06-19 Fix: limpiar GRAM muerto del panel JD9853 (ruido borde superior)
    El panel nativo es 240x320 pero el canvas usa 296px con row_offset=12,
    dejando las filas 0-11 y 308-319 del GRAM sin escribir. Ese GRAM aleatorio
    asoma por las esquinas redondeadas del cristal IPS como ruido visible.
    Se añade clearNativePanel(color) a Arduino_JD9853 que envía CASET/RASET/RAMWR
    directamente al bus (sin writeAddrWindow, que suma los offsets) para cubrir
    las 240x320 lineas fisicas completas con el color indicado.
    Se llama una vez en setup() tras tft->begin() y antes del primer canvas->flush().
    [jd9853_panel.h, main_esp32.cpp]
2026-06-19 Refactor: constantes safe-area en DisplayRendererColor
    Elimina magic numbers del layout y centraliza las dimensiones del panel
    (kScreenW/H), margen de borde fisico (kEdgeInset=8), radio de esquinas
    de cards (kCornerR=10), sangrado de texto (kSafeTextX) y alturas de HUD
    (kHudTopH=44, kHudBottomH=60).
    Actualiza tambien el comentario de layout en el header para reflejar el
    nuevo diseno de cards redondeadas con safe-area.
2026-06-19 Feature: HUD cards redondeadas safe-area (top/bottom)
    drawHudTop_(): sustituye fillRect(0,0,240,40) por fillRoundRect con
    kEdgeInset/kHudTopH/kCornerR. Etapa en size 2 blanco como titulo;
    edad en size 1 COL_GRAY como subtitulo. Cursor WiFi movido a
    cx = kScreenW-kEdgeInset-14 para quedar dentro de la card.
    drawHudBottom_(): sustituye fillRect+drawFastHLine por fillRoundRect
    con kEdgeInset/kHudBottomH/kCornerR. Label centrado con clamp minimo
    en kSafeTextX. Cursor dots subidos desde y=282 a la parte baja de la
    card (cardY + kHudBottomH - 10 - dotSize).
    drawSprite_(): spriteY recalculado para centrar verticalmente el sprite
    en la zona libre entre las dos cards (zoneTop..zoneBottom).
    drawOve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
2026-06-19 Refactor: HUD limpio sin cards (texto flotante sobre fondo)
    Elimina fillRoundRect COL_DARKGRAY de drawHudTop_ y drawHudBottom_.
    Texto e iconos flotan directamente sobre el fondo azul COL_BG.
    Corrige huecos del icono WiFi (COL_DARKGRAY → COL_BG) para que el
    icono se integre correctamente sin dejar manchas grises sobre el azul.
    Separador en drawStatsView_ cambiado de COL_DARKGRAY a COL_GRAY.
    COL_DARKGRAY queda sin usos en drawing calls (solo definida).
2026-06-19 Fix: holgura de esquina redondeada en HUD superior (BABY + WiFi)
    Añade kCornerSafe=28 como clearance diagonal de la esquina del cristal IPS.
    drawHudTop_() mueve el texto BABY/etapa a (28,28) y la edad a (28,46); el
    icono WiFi pasa de cx=218,cy=24 a cx=212,cy=28, despejando ambas esquinas
    del cuarto de círculo recortado. kHudTopH sube de 44 a 52 px para que la
    zona del sprite no solape el texto desplazado.
2026-06-19 Feature: carcasa Tamagotchi parametrica FreeCAD (rear-body + front-bezel)
    Script headless build_case.py genera dos solidos Part via boolenas, gobernados
    por Spreadsheet Params (67 alias, cero valores hardcoded). Validacion parametrica
    bat_w 30->34 pasa sin romper. Ambos solidos: valid=True, closed=True, 1 solid.
    STLs exportados: rear-body (924 tri) y front-bezel (452 tri).
    [front-bezel.stl, rear-body.stl, tamagotchi-case.FCStd]
2026-06-19 Feature: component reference mockups + bezel lip collision fix
    Adds add_component_mockups.py:
    - 5 dimensional reference solids (Battery grey, ESP32 green, TP4056 orange, TFT blue, TTP223 yellow)
    - grouped under App::DocumentObjectGroup 'Components' (excluded from STL export)
    - USB-C connector blocks on MCU and TP4056 aligned to existing -X wall cutouts
    - Active area marker (cyan) on TFT PCB front face
    - Full collision verification: Shape.common() volume vs RearBody and FrontBezel for each component
    - Containment check of bounding boxes vs interior cavity
    - USB-C cutout alignment report
    Fix in build_case.py (FrontBezel lip ring):
    - Changed lip_inner Z height from (lip_od_z - 2*lip_th) to (li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
    [front-bezel.stl, tamagotchi-case.FCStd]
2026-06-19 Feature: bisel con boton capacitivo concavo tipo Home, elimina chaflan
    - Elimina el chaflan diagonal (Chamfer_FrontTop) por completo; bezel
    vuelve a placa rectangular plana.
    - bezel_th reducido de 8mm a 5mm (minimo funcional: btn_depth + btn_wall
    + margen = 1.5 + 1.4 + 2.1).
    - Nuevo boton Home-style: rebaje esferico concavo (R=19.5mm, depth=1.5mm,
    dia=15mm) centrado en X, en franja inferior (Z=14.65mm auto-derivado).
    - TTP223 reubicado a cara interior del bisel (pocket 15.4x11.4mm, depth
    2.1mm desde cara inner), detras del boton. btn_wall=1.4mm garantiza
    acoplamiento capacitivo.
    - Ventana de pantalla reposicionada: area activa real 27.1x32.5mm,
    Z_ctr=43.57, margen superior=10.2mm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
    [front-bezel.stl, front-bezel_2026-06-20.stl, tamagotchi-case.FCStd]
2026-06-19 Feature: integra mockups de componentes en pipeline principal + reubica TTP223 tras boton
    - Mueve _comp_box, _component_positions, _verify_components y
    add_component_mockups a build_case.py (antes de main()), eliminando
    la dependencia de add_component_mockups.py en tiempo de ejecucion.
    - build_case.py regenera siempre Params + Body_RearBody + Body_FrontBezel
    + los 5 Comp_* en una sola ejecucion: los mockups nunca se pueden
    volver a perder al rebuildar la carcasa.
    - TTP223 posicionado correcto: cx=0, Z=btn_center_z (14.65 mm),
    dentro del pocket de la cara interior del bezel (Y=20..22.1 mm global),
    pad orientado hacia -Y (hacia el boton concavo). Sin chaflan.
    - Transparencia Body_R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
    [tamagotchi-case.FCStd]
2026-06-20 Feature: caja 44mm + bateria real 50x35x7 + bosses esquema D sin colision
    - ext_x: 40 → 44 mm (SET B arquitecto). int_x pasa a 40 mm.
    - Batería real LiPo 505070 (50×35×7 mm) tumbada plana contra pared −Y:
    bat_t=7 (grosor Y), bat_w=35 (ancho X), bat_h=50 (alto Z).
    - Bosses esquema D: 2 inferiores (cz=2, top=7) + 2 superiores (cz=63, top=68=ez-wall).
    boss_off_x = ext_x/2 − boss_r = 19.5 mm (flush con exterior, solids únicos).
    boss_h=5 mm para que quepa en ambos extremos de cav_z=66.
    - bat_z0 = boss_z_bot + boss_h + 1.5 = 8.5 mm (batería sobre bosses inferiores).
    - bat_z_top = 58.5 mm, sup boss base 63 → Z-gap = 4.5 mm. 0 colisión 3D.
    - Todas las colisiones de componentes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
    [front-bezel.stl, front-bezel_2026-06-20.stl, rear-body.stl, tamagotchi-case.FCStd]
2026-06-20 Feature: distribucion optima - bateria tras pantalla, boton simplificado, fillets, USB unico
    Parametros aplicados (plan arquitecto 2026-06-20):
    - btn_dia=12 btn_depth=0.6 btn_wall=1.0 btn_center_z=9 (fijo, franja inferior)
    - bat_center_z=40.5 bat_z0=15.5 bat_swell=1.0 (bateria pegada pared -Y adhesivo)
    - boss_od=4.0 boss_id=1.5(M2 self-tap) boss_z_bot=4 boss_z_top=62 boss_off_x=20.0
    - clr_fit=0.15 mcu_center_z=9 tp_center_z=22 (posiciones absolutas)
    - USB-C UNICO en -X (TP4056); ESP32 USB interno sin cutout
    - fillet_ext_vert=4.0 fillet_ext_horiz=2.0 fillet_int=0.5
    - Todos los checks V1-V8 PASS; colisiones=0; parametrizacion validada bat_t 7->8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
    [front-bezel.stl, front-bezel_2026-06-20.stl, rear-body.stl, tamagotchi-case.FCStd]
2026-06-20 Fix: bisel encaja en el cuerpo (44x40) + aplica fillets redondeados
    Defecto 1 — Bisel mal dimensionado:
    Causa raiz: transformGeometry() sobre shapes con superficies curvadas
    (esfera del boton) distorsiona el BoundBox de OCC, inflando X a ±23.18
    (deberia ser ±22) e Y hasta 41.73 mm (deberia ser max 25).
    Fix: build_front_bezel() construye directamente en coordenadas globales
    (Y=20..25 para blank, Y=16..20 para lip). Se elimina mat.move +
    transformGeometry de main(). BB resultado: X[-22..22] Y[14.94..25.60].
    Defecto 2 — Fillets no aplicados:
    Fix: estrategia fillet-first validada en headless:
    - RearBody: fillet el outer solid (r_vert=4.0, r_horiz=2.0) ANTES de
    cortar c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
    [front-bezel.stl, front-bezel_2026-06-20.stl, rear-body.stl, tamagotchi-case.FCStd]
2026-06-20 Refactor: rediseño topología 2 piezas — Body_Main + Rear_Cover, tornillos eje Y
    - Body_Main: frontal +Y macizo integral (bezel_th=5mm), cavidad abierta por -Y,
    4 bosses eje Y (cyl_y helper, NO cyl eje Z), recess perimetral boca -Y,
    batería en pared interior fija (front_int_y=+15), pockets MCU/TP4056/pantalla/TTP223
    - Rear_Cover: tapa plana cover_th=2.5mm, labio macho perimetral clr_slide=0.15,
    4 pasantes M2 Ø2.4 + counterbore Ø4 prof=2.0mm (oculto < cover_th), sin ventana
    - Parámetros nuevos: cover_th, cbore_depth, screw_len, screw_thread_engage,
    boss_z_bot/top reinterpretados como CENTRO Z del eje del boss (no base)
    - Derivados: boss_y0, interface_y, boss_len_y=32.5mm, pilot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
    [body-main.stl, rear-cover.stl, tamagotchi-case.FCStd]
2026-06-21 Fix: 3 bugs enclosure — tapa sólida, postes cortos, esfera acotada
    BUG 1 (Rear_Cover): Reescribe build_rear_cover con placa sólida sin fillet,
    fuse(placa+labio) con solape lip_overlap=1.0mm, y fillet-LAST sobre el
    conjunto. Abort explícito si Solids!=1 tras el fuse (sin except:pass silencioso).
    Resultado: Solids=1, Volume=9178mm³ (antes 1667), BBox=44×6.5×70.
    BUG 2 (Bosses largos): Reescribe §2.9 con postes cortos boss_post_len=10mm
    anclados en Y[-17.5..-7.5]. Elimina §2.10 ribs. Gap de 22.5mm hasta front_int_y,
    cero caras cilíndricas de postes en zona frontal Y[14..20].
    BUG 3 (Esfera sin acotar): Acota el cortador esférico con dish=sphere.common(local_box),
    donde local_box=(bt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
    [body-main.stl, rear-cover.stl, tamagotchi-case.FCStd]
2026-06-21 Fix: tapa con esquinas redondeadas r4 coincidiendo con el cuerpo
    Reescribe build_rear_cover() con estrategia bloque-único para evitar el
    fallo OCC en la junción placa+labio. Construye un solo makeBox 44×6.5×70,
    filletea (rv=3.20 cabe en 6.5mm, rh=2.0) y luego vacía la zona del labio
    en dos pasos: recorte perimetral exterior a lip_od 43.70×69.70 y vaciado
    interior dejando anillo de pared 1.85mm. Resultado: 10 toroides, placa
    redondeada r4 coincide con Body_Main, Volume=8517mm³, BoundBox 44×6.5×70,
    todos los checks PASS, STL re-exportado.
    [rear-cover.stl, tamagotchi-case.FCStd]
2026-06-21 Feature: tornilleria M3x5 avellanada + isla rebajada, tornillos reposicionados
    - M2 → M3x5 countersunk 90° al ras: screw_head_d=6, screw_clear_d=3.4, screw_len=5, engage=3.5mm
    - boss_id=2.5 (PLA self-tap), boss_od=6.5 (derivado), boss_off_x=17.5 fijo
    - Postes reposicionados: Y[-18.5..-10.5] (boss_post_len=8), pilot Y[-18.5..-14.0] (pilot_len=4.5)
    - Isla rebajada Opcion A: Ø10mm, th=1.5mm en tapa, rebaje 1mm Y[-18.5..-17.5]
    - Avellanado conico: r1=3.0→r2=1.7, cs_depth=1.3mm desde cara ext (cabeza al ras)
    - V-CS1..V-CS10 todos PASS: margen_cabeza=1.5mm, solape_pared=0.75mm, engage=3.5mm,
    aire_cs=0.2mm, aire_punta=1.0mm, colisiones bat/MCU=0, coaxialidad garantizada
    - Spreadsheet actual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
    [body-main.stl, body-main_2026-06-21.stl, rear-cover.stl, rear-cover_2026-06-21.stl, tamagotchi-case.FCStd]
2026-06-21 Fix: concavidad del boton era pasante - corregido centro de la esfera (casquete 0.6mm)
    Fórmula btn_sphere_cy_global: ext_y/2 - btn_sphere_r + btn_depth (WRONG, centro en -9.7, pasante)
    -> ext_y/2 + btn_sphere_r - btn_depth (FIX, centro en +49.7, casquete de 0.6mm desde Y=+20)
    Verificado headless: Y_max en centro botón = +19.4 (fondo concavidad), pared neta = 1.0mm, NO pasante.
    [body-main.stl, tamagotchi-case.FCStd]
2026-06-21 Fix: eliminar header pocket que atravesaba la cara frontal (cuadrado visible)
    El hdr_pocket cortaba hacia +Y con cy≈+19.96, atravesando la pared frontal
    exterior (Y=+20) y generando un hueco cuadrado visible desde el frente bajo
    la pantalla. El header de 8 pines sobresale hacia -Y (cavidad abierta) y
    no necesita pocket: se elimina el bloque completo.
    Verificado headless: CHECK 1 PASS (frente limpio Z[8,27]), CHECK 2 PASS
    (ventana pantalla through-hole intacta), CHECK 3 PASS (pcb_pocket intacto),
    Body_Main Solids=1 isValid isClosed Vol=23944 mm³ BBox≈44×40×70.
    [body-main.stl, body-main_2026-06-21.stl, tamagotchi-case.FCStd]
2026-06-21 Fix: tapa trasera uniforme (eliminar islas rebajadas) + M3x6 para mantener agarre
    - Elimina los 4 cilindros rebajados Ø10×1mm de la cara interior de la tapa
    - Tapa queda plana y uniforme 2.5 mm en toda su superficie
    - screw_len 5→6 mm (M3×6) para compensar: engage útil = 3.5 mm
    - boss_y_start recalculado: −18.5 → −17.5 (cara interior tapa uniforme)
    - boss_y_end: −10.5 → −9.5; pilot Y[−17.5..−13.0]
    - punta tornillo Y=−14.0, fin piloto Y=−13.0, aire=1.0 mm ✓
    - V-CS9b (4 sondas grosor ex-isla): 2.500 mm cada una ✓
    - Todos V-CS1..V-CS10 PASS
    [body-main.stl, rear-cover.stl, tamagotchi-case.FCStd]
2026-06-21 Fix: poste de tornillo de esquina macizo y anclado (interrumpir recess del labio + muesca en tapa)
    - §2.3: subtract 4 corner keepout boxes from recess_cut before cutting shell;
    keepout covers X[±13.75..±22.1] × Y[-20..-13.5] × Z[bz±5.25mm] per boss corner.
    Recess no longer carves the boss-wall junction → boss+wall continuo en Y[-17.5..-9.5].
    - §2.9: add web gussets (lateral + horizontal) per boss corner in lip zone Y[-17.5..-13.5]
    to reinforce boss↔wall and boss↔floor/ceiling anchoring.
    - §3.3c: cut matching notch from rear cover lip at each corner
    (notch_xi=13.60, notch_zh=±5.40 = keepout + clr_slide 0.15mm) so cover closes cleanly.
    - derive(P): new keepout/notch/web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
    [body-main.stl, rear-cover.stl, tamagotchi-case.FCStd]
2026-06-21 Fix: eliminar canal de cable y webs flotantes; postes de tornillo limpios y simetricos
    - §2.14: elimina canal de cable 5×5 mm en esquina -X/-Y que carcomia los postes -X.
    - §2.9: elimina web gussets A (lateral) y B (horizontal) que generaban rectangulos
    volantes desconectados visualmente del cuerpo.
    - §2.9: sustituye webs por anchor blend continuo poste↔pared lateral a lo largo
    de TODA la altura del poste Y[-17.5..-9.5] (blend_z_h=boss_od=6.5 mm,
    blend_x_w=8.26 mm desde keepout_x_inner hasta wall exterior).
    - Resultado: 4 postes identicos, simetricos ±X (area 50.59 mm² en Y=-16/-15/-14,
    diff +X vs -X = 0.00 mm²); anclaje continuo vol>1.74 mm³ en los 5 puntos Y.
    - Body_Main: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
    [body-main.stl, tamagotchi-case.FCStd]
2026-06-21 Fix: junta cuerpo-tapa sin colision (placa a ras + labio interior)
    Sustituye recess+keepout por rebaje perimetral Y[-20..-17.5] en Body_Main
    y construye la tapa con labio interior (anillo X[18..19.85]) usando
    vaciado selectivo de bloque unico para obtener Solids=1, isValid=True.
    Body_Main.common(Rear_Cover).Volume = 0.0000 mm3 (criterio < 1 mm3: PASS).
    Todos los checks V-CS1..V-CS10 + V-BOSS-FIX + V-CS-COLLISION: PASS.
    Parametricidad verificada: cover_th 2.5->3.0 y clr_slide 0.15->0.2 propagan.
    [body-main.stl, body-main_v2026-06-21.stl, rear-cover.stl, rear-cover_v2026-06-21.stl, tamagotchi-case.FCStd]
2026-06-21 Fix: eliminar anchor_blend (ruido alrededor de los postes); postes limpios unidos a la pared
    El bloque anchor_blend (caja recta fusionada al poste) generaba caras planas
    que sobresalían hacia la cavidad y "ventanas" feas. Eliminado: el poste cilíndrico
    (cx=±17.5, Ø6.5 → extremo X=±20.75) ya solapa 0.75 mm con la pared lateral
    interior (X=±20) a lo largo de todo Y[-17.5..-9.5] → anclaje continuo sin ruido.
    V-BOSS-FIX (a-f) PASS, V-CS-COLLISION=0.0000 mm³, Solids=1/valid/closed.
    [body-main.stl, tamagotchi-case.FCStd]
2026-06-21 Chore: limpiar STL obsoletos y regenerar FCStd/STL del diseño final; ignorar .FCBak/.svg
    - Elimina 7 STL de versiones intermedias y arquitectura vieja (body-main_2026-06-21, body-main_v2026-06-21, front-bezel, front-bezel_2026-06-20, rear-body, rear-cover_2026-06-21, rear-cover_v2026-06-21)
    - Regenera tamagotchi-case.FCStd desde commit final 25c4d66
    - Añade patrones *.FCBak y hardware/case/*.svg a .gitignore (archivos temporales regenerables)
    [body-main_2026-06-21.stl, body-main_v2026-06-21.stl, front-bezel.stl, front-bezel_2026-06-20.stl, rear-body.stl, rear-cover_2026-06-21.stl, rear-cover_v2026-06-21.stl, tamagotchi-case.FCStd]
2026-06-21 Feature: cambiar input ESP32-S3 de GPIO0 (BOOT) a GPIO4 (TTP223 active-HIGH)
    PIN_BUTTON pasa de 0 a 4; BUTTON_ACTIVE_LOW y BUTTON_PULLUP_ACTIVE pasan a
    false en la rama ESP32. GPIO4 es pin seguro (no strapping). Actualiza
    comentarios del bloque condicional para reflejar el nuevo hardware.
2026-06-21 Refactor: actualizar comentarios y LOG_INFO de InputHandler a TTP223/GPIO4
    Sustituye referencias a 'botón BOOT / GPIO0' y 'active-LOW / pull-up'
    por 'TTP223 / GPIO4' y 'active-HIGH / sin pull-up' en main_esp32.cpp.
2026-06-21 Feature: boot splash Game Boy DMG estilo para Furbygotchi
    Módulo BootSplash: logo pixel-art "Furbygotchi" que cae desde arriba,
    rebota una vez en el centro vertical y se mantiene ~1.3s antes de ceder
    paso al primer frame real. Bitmap 1-bit 65×7 px dibujado a mano con trazo
    redondeado estilo BIOS Game Boy; renderizado nearest-neighbor ×3.
    Estructura split para compatibilidad con env:native:
    - BootSplashLogic/ : constantes + bootSplashLogoY() sin dependencias GFX.
    - BootSplash/ : bitmap + playBootSplash(canvas) usando Arduino_GFX.
2026-06-21 Feature: integrar playBootSplash() en setup() de main_esp32.cpp
    Reemplaza el splash estático de texto (fillScreen + print) por la llamada
    a playBootSplash(canvas), que ejecuta la animación DMG completa antes de
    que arranque LittleFS y SpriteStore.
2026-06-21 Feature: configurar platformio.ini para BootSplash en env:native y env:esp32s3
    - env:native: lib_ignore = BootSplash (excluye el módulo GFX del build native);
    BootSplashLogic sí se compila; añade -Ilib/ui/BootSplashLogic y lib/ui a
    lib_extra_dirs para que el LDF lo resuelva.
    - env:esp32s3: lib/ui ya en lib_extra_dirs; ambos módulos se compilan.
2026-06-21 Test: tests unitarios para bootSplashLogoY() (Unity, env:native)
    5 casos con nombres descriptivos que verifican:
    - Logo arranca fuera de pantalla (y negativo en frame 0).
    - Llega exactamente al centro vertical en frame kFallFrames.
    - Hay overshoot por debajo del centro durante la fase de rebote.
    - Se mantiene en kYFinal al final y con clamp fuera de rango.
    - La caída es monotónicamente no decreciente.
2026-06-21 Refactor: logo Furbygotchi en negrita y más legible en boot splash
    Rediseño completo del bitmap 1-bit: glyphs de 5×7 fino → 7×9 bold
    con strokes de 2 px. Escala ajustada de ×3 a ×2 (174×18 px en pantalla,
    cabía a 195×21 pero el trazo grueso requería más ancho por glyph).
    y/g con descendente visible en filas 7-8. r, c, h, i redibujadas claras.
2026-06-21 Refactor: fondo de la app de azul oscuro a negro puro (COL_BG 0x0000)
2026-06-22 Feature: assets de estado/acción/menú (iconos + escoba + jeringa) RGB565
    11 sprites pixel-art generados con Gemini Flash y exportados a RGB565:
    - 9 iconos 24x24 (1 frame idle): ic-hunger, ic-poop, ic-sick, ic-apple,
    ic-ball, ic-moon, ic-heal, ic-disc, ic-stats
    - 2 animaciones 48x48: anim-broom (6 frames broom), anim-syringe (5 frames syringe)
    Colorkey 0xF81F (bgColor #FF00FF). Tamaños verificados (w*h*2 bytes).
2026-06-22 Feature: regenerar syringe/disc/hunger + nueva anim pelota (correcciones arte)
    - anim-syringe: regenerado a 3 frames, solo émbolo/plunger sin mano;
    elimina frames 3 y 4 del set anterior de 5
    - ic-disc: reemplazado por signo de exclamación bold amarillo (legible a 24px)
    - ic-hunger: reemplazado por cubiertos cruzados en color con contorno oscuro
    - anim-ball: nuevo sprite 48x48, 3 frames pelota botando (acción Play)
    Todos verificados: 0 px magenta dentro del objeto, tamaños w*h*2 correctos.
2026-06-22 Feature: canal overlay one-shot para animaciones de acción (escoba/jeringa/pelota)
    Añade un segundo canal de animación independiente que se pinta ENCIMA del
    personaje durante kActionAnimDurationMs sin tocar su mood ni su frame counter.
    Mapeo acción → overlay:
    Clean → broom (escoba, 6 frames, a los pies del personaje)
    Heal → syringe (jeringa, 3 frames, costado derecho)
    Medicate → syringe (ídem)
    Play → ball (pelota, 3 frames, esquina inferior-derecha)
    Feed → sin overlay (la animación Eat del personaje es suficiente)
    Nuevos campos en DisplayRendererColor (header):
    overlayAnimFrames_, overlayAnimRemainingMs_,
    overlayAnimFrame_, over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
2026-06-22 Feature: icono + label en HUD inferior del menú de acciones (Fase 4 C1)
    - drawHudBottom_(): pinta bloque [icono 24px | gap 6px | label size 2]
    centrado horizontalmente en la card inferior (60 px de alto).
    Dots de cursor en franja inferior, sin cambios.
    - loadMenuIcons_(): precarga 6 iconos 24×24 desde SpriteStore en begin().
    Feed→ic-apple, Play→ic-ball, Discipline→ic-disc, Sleep→ic-moon,
    Heal→ic-heal, Stats→ic-stats. ~7 KB PSRAM.
    - drawMenuIconPrimitive_(): iconos con primitivas para Clean (escoba) y
    Medicate (cápsula roja/blanca). Decisión: anim-broom/anim-syringe son
    48×48 y no caben en el HUD de 60 px junto al texto size 2 (16 px alto
    + márgenes). Las primi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
2026-06-22 Feature: iconos de estado grandes centrados en banda superior (D1)
    - drawStatusIconsTop_(): renderiza ic-hunger/ic-poop/ic-sick como sprites
    24×24 escalados ×2 (48×48) centrados horizontalmente en la banda superior.
    Solo los needs activos aparecen; startX=(240-(n*48+(n-1)*8))/2.
    - loadSprites_(): precarga los 3 iconos de estado en PSRAM al boot junto
    con los sprites de etapa. Log de PSRAM libre tras precarga ya existente.
    - drawHudTop_(): queda solo con WiFi; etapa/edad movidas a las escenas que
    las necesitan (StatsView, DeadScreen) para liberar la banda superior.
    - drawStatsView_(): ahora muestra etapa+edad en esquina sup-izq (kCornerSafe).
    - drawDeadScreen_(): idem, reproduce et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
2026-06-23 Fix: revertir ic-hunger al sprite anterior (cubiertos previos, gusta mas que la version a color)
2026-06-23 Fix: uuid ic-hunger, degradacion per-icono y escala personaje 4→3
    - Fix 1: kIconHungerId corregido a 5965792e... (coincide con manifest.json)
    para que el sprite ic-hunger cargue correctamente y elimine la barra amarilla.
    - Fix 1b: eliminado flag global statusIconsLoaded_; un fallo de carga de icono
    deja solo ese slot con count=0, sin apagar los otros dos (poop/sick).
    drawStatusIconsTop_() usa el chequeo per-slot que ya tenía (count > 0).
    - Fix 2: kScale 4→3 (192×192 → 144×144 px); el personaje queda centrado en
    la zona de juego sin pisar la banda de iconos ni el HUD inferior.
2026-06-23 Fix: huevo con fondo colorkey + centrado del personaje por tamano real
    - egg/idle re-exportado: fondo 0xE253 opaco a 0xF81F colorkey (era el cuadrado rosa); 6 frames de wobble
    - drawSprite_: spriteX/Y usan spriteW/spriteH reales en vez de 192 fijo (descentraba con kScale=3)
2026-06-23 Fix: recortar huevo a 2 frames de wobble (LittleFS al limite de capacidad)
    Los 6 frames re-exportados rebasaban la particion LittleFS (FS full en uploadfs).
    2 frames bastan para el wobble del huevo y mantienen el fondo colorkey correcto.
2026-07-12 Feature: BatteryGauge puro — curva mV→%, filtro, histéresis y deteccion Unknown
    Módulo sin Arduino.h (compilable en host-native): gate de plausibilidad +
    estabilidad para distinguir un pin ADC flotante de un divisor real soldado
    (8 muestras consecutivas en rango y estables para salir de Unknown, 4 fuera
    de rango para volver), media móvil de 8 muestras, curva LiPo 1S por tramos
    con interpolación lineal, histéresis de % para evitar parpadeo, y heurística
    de carga (umbral sostenido + pendiente positiva) fusionable con un pin
    externo (VbusPresence / ChargeLedActiveLow). El tiempo entra por parámetro
    (nowMs), nunca por millis(), para que sea determinista y testeable.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
2026-07-12 Test: suite nativa de BatteryGauge (curva, gate de plausibilidad, heuristica de carga)
    16 tests en pio test -e native cubriendo: breakpoints/interpolación/clamp/
    monotonía de la curva mV→%; boot en Unknown; 8 muestras estables entran en
    valid; pin flotante fuera de rango nunca valida; pin flotante DENTRO de
    rango pero con jitter >120mV nunca valida (caso clave del gate); glitch
    único no invalida pero 4 seguidos sí; histéresis de % sin flicker; carga
    por umbral sostenido y por pendiente positiva; fusión con VbusPresence y
    ChargeLedActiveLow; addSample devuelve true solo cuando el estado publicado
    cambia. Las 129 pruebas del proyecto (todas las suites) siguen en verde.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
2026-07-12 Feature: BatteryMonitor infra + evento BatteryStateChanged + pines en config.h
    Añade el evento BatteryStateChanged al EventBus (payload empaquetado:
    bits 0-6 percent, bit 7 charging, bit 8 valid), los defines de pinout en
    config.h (GPIO1 divisor VBAT, GPIO2 sensado de carga — ambos pendientes de
    soldadura, ver docs/hardware-battery.md) y el módulo BatteryMonitor (infra
    ESP32): ráfaga de 9 analogReadMilliVolts descartando la primera y
    promediando 8, compensación del divisor, alimenta BatteryGauge y publica
    el evento solo cuando el snapshot cambia, con log único si nunca detecta
    hardware. main_esp32.cpp instancia el monitor y decodifica el evento en un
    handler de solo log — el setter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
2026-07-12 Feature: icono de bateria con primitivas en HUD + porcentaje en StatsView
2026-07-12 Feature: campos de bateria en /api/v1/state e /info
    JsonCodec::serializeState, serializeActionResponse y serializeInfo ganan
    parametro const BatterySnapshot&. Campos camelCase siempre presentes en
    data (backward compatible, api-conventions.md): batteryPercent,
    batteryCharging, batteryValid; serializeInfo suma ademas
    batteryMillivolts (endpoint canonico de telemetria detallada).
    WebUI inyecta const BatteryMonitor& battery_ en el ctor (mismo patron
    que wifi_) y pasa battery_.snapshot() en los tres handlers. Sin caso
    especial para BATTERY_SENSE_ENABLED=0: BatteryMonitor::snapshot() ya
    devuelve {valid:false,...} de forma natural cuando el gauge nunca recibe
    muestras (feature compilada-fuera), a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
2026-07-12 Feature: indicador de bateria en el dashboard web
2026-07-12 Docs: guia de soldadura del medidor de bateria + README
    Documenta el divisor VBAT (GPIO1) y las dos opciones de sensado de
    carga (GPIO2) con procedimientos de verificacion con multimetro, para
    que la soldadura pendiente pueda hacerse en otra sesion sin repasar
    el codigo. README enlaza la guia y refleja el estado actual.
2026-07-13 Fix: gate de plausibilidad exige muestras consecutivas y charging gateado por validez
    Review adversarial de la feature de medidor de bateria detecto 5 defectos en
    BatteryGauge, todos corregidos con tests de regresion:
    - CRITICO: una muestra implausible mientras !valid_ solo hacia `return` sin
    limpiar el ring, rompiendo el contrato de "8 muestras CONSECUTIVAS" del .h
    — un pin flotante que alterna dentro/fuera de rango podia acumular 8
    plausibles NO consecutivas y validar por error. Ahora clearRing_() en esa
    rama rompe la racha.
    - MAJOR: updateCharging_ se ejecutaba con valid_==false, pudiendo exponer
    batteryCharging=true con batteryValid=false en la API, y dejar charging_
    "cong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
2026-07-13 Fix: WebUI desacoplada de BatteryMonitor — restaura el build ESP8266
    El env esp12e no compilaba: src/main.cpp construye WebUI con 4 argumentos
    pero WebUI.h exigia un 5o parametro const BatteryMonitor&, y BatteryMonitor.h
    es infra ESP32-only (analogSetPinAttenuation via Arduino.h) que el LDF podia
    arrastrar al build ESP8266.
    Desacople: WebUI ya no conoce BatteryMonitor, solo BatteryGauge (lib/core,
    logica pura sin Arduino.h). El 5o parametro del ctor pasa a ser un puntero
    nullable `const BatteryGauge*` (default nullptr) — con nullptr los handlers
    usan un BatterySnapshot{} vacio (valid:false), mismo contrato de API que un
    BatteryMonitor real sin hardware detectado. BatteryMonitor expone g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
    [main_esp32.cpp]
2026-07-13 Fix: guards y geometria del icono de bateria + a11y del badge web
    DisplayRendererColor.cpp:
    - drawBatteryIcon_ pintaba encima de la pantalla RIP: drawDeadScreen_ llama a
    drawHudTop_ (WiFi + bateria) pero el guard de drawBatteryIcon_ no
    contemplaba DeadScreen (solo OtaProgress/StatsView). Anadido.
    - El borne del icono colisionaba 1px con el bloque de status icons cuando
    hay 3 activos (bloque centrado arranca en x=40, borne original acababa en
    x=41). Icono completo desplazado 4px a la izquierda (cuerpo x=12, borne
    acabando en x=37).
    - El rayo de carga pintaba sobre el borde inferior del cuerpo (fillTriangle
    llegaba a y=33, borde del drawRect en y=33). Vertices ajustados a y<=32.
    d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
2026-07-13 Test: cobertura de serializeActionResponse con bateria y docs del condensador ADC
    El divisor 2x100k presenta ~50kOhm Thevenin, alta para el sample&hold del
    ADC del S3 — se documenta C1 100nF en el punto medio como filtro.
2026-07-13 Fix: WiFi.setSleep(false) — el modem sleep perdia los UDP de invitacion OTA
    Con el sleep por defecto, el router (DTIM alto) tira los UDP unicast
    al puerto 3232 mientras el radio duerme: espota falla con 'No response'
    aunque HTTP (TCP) y mDNS (multicast) funcionen. Diagnosticado tras ~12
    intentos de OTA fallidos con señal excelente y dispositivo recien
    reiniciado.
2026-07-13 Fix: ignorar Videos/ — media personal fuera del repo
2026-07-13 Feature: actualizacion del modelo de carcasa + proyecto de slicer 3MF
    El .3mf acompaña a los STL existentes con los ajustes de impresion.
    [Tamagotchi.3mf, tamagotchi-case.FCStd]
2026-07-13 Fix: eliminar setPort(8266) — el OTA del ESP32 escuchaba en el puerto del ESP8266
    Causa raiz (encontrada por superdev): OTAManager.cpp arrastraba
    `ArduinoOTA.setPort(8266)` del porting original ESP8266. El ESP32-S3
    escuchaba en el puerto 8266 mientras espota/ArduinoOTA de ESP32 sondea por
    defecto el 3232 — el flasheo remoto nunca recibia respuesta.
    - OTAManager.cpp: eliminado setPort(8266). Sin setPort() explicito, cada
    plataforma usa su default correcto (ESP32->3232, ESP8266->8266), asi que
    env:esp12e_ota sigue funcionando igual. LOG_INFO ya no menciona un puerto
    hardcodeado.
    - OTAManager.h: comentarios de cabecera ya no arrastran "Puerto 8266" ni
    "ESP8266mDNS.h" (documentacion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
    [main_esp32.cpp]
2026-07-13 Feature: lectura cruda del ADC de bateria en /api/v1/info
    El usuario soldo el divisor de VBAT a GPIO1 pero el gauge no valida (sigue
    Unknown tras 30+s) y el snapshot publico gatea millivolts a 0 hasta valid —
    no hay forma de ver que esta leyendo realmente el pin para diagnosticar
    (soldadura floja, GND no comun, resistencias equivocadas, o simplemente
    pin flotante sin nada soldado).
    - BatteryGauge: nuevo lastRawMv_ actualizado en CADA addSample() antes de
    cualquier gate (plausible o no) + getter lastRawMillivolts(). Nuevo getter
    consecutivePlausible() que expone ringCount_ (0-8): progreso real del gate
    de validez, para ver si esta "a punto" de validar o si cada muestra rompe
    la rac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
2026-07-13 Feature: panel de sistema en el dashboard (firmware, red, bateria en crudo)
    Nueva seccion "Sistema" (colapsable via <details>/<summary> nativo,
    colapsada por defecto) al final del dashboard, con polling propio de
    GET /api/v1/info cada 10s:
    - Firmware: version (hex, 0xMMmm — igual formato que include/config.h).
    - Uptime formateado ("2h 14m").
    - RAM libre en KB.
    - WiFi: RSSI en dBm + etiqueta de calidad (>-60 buena / -60..-75 media /
    <-75 mala).
    - Bateria (diagnostico de la soldadura del divisor VBAT):
    - Estado del sensor: "No detectado" (raw fuera de 2800-4350mV) /
    "Detectando... (N/8)" (raw plausible, gate en progreso) / "OK" (valid).
    - Lectura cruda (batteryRawMillivolts)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
2026-07-13 Feature: identidad de red (IP, hostname, MAC) en /api/v1/info y panel Sistema
    Extension directa del panel Sistema: JsonCodec::serializeInfo gana 3
    parametros (ipAddress, hostname, macAddress) -> campos string camelCase
    homonimos en data, junto a wifiRssi. SIEMPRE presentes (cadena vacia si
    WiFi caido, nunca null ni omitidos - api-conventions.md).
    - WebUI::handleGetInfo_: WiFi.localIP().toString() y WiFi.macAddress()
    devuelven Arduino String temporales - se guardan en variables locales
    (ipStr/macStr) antes de pasar sus .c_str(), porque JsonCodec no copia los
    const char* que recibe (zero-copy) y el buffer subyacente debe seguir vivo
    durante toda la llamada a serializeInfo. hostname es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
2026-07-13 Fix: etiquetas de bateria del panel Sistema autoexplicativas
    'Lectura cruda' → 'Tensión instantánea (ADC)' y 'Filtrado' →
    'Tensión media / nivel' — feedback de UX de Guillermo.
2026-07-13 Fix: eliminar boton Heal redundante del dashboard web
    El stat "health" y el boton Medicate se mantienen intactos; solo se
    retira la accion Heal (boton, referencia DOM y listener a
    /api/v1/heal), cuyo endpoint esta siendo eliminado del firmware.
2026-07-13 Fix: eliminar accion Heal redundante del firmware
    Se retira Heal de ActionKind (dominio), StatsEngine::applyHeal(),
    el endpoint POST /api/v1/heal + evento ActionHealRequested, ambos
    renderers (mono ESP8266 y color ESP32-S3, iconos/labels/overlays) y
    PayloadValidator. Medicate (isSick -> health +20) queda como unica
    via de curacion; sin isSick, la unica recuperacion pasiva de health
    es dormir (StatsEngine ya regenera ~2 pts/s en applySleep). Se
    regeneran sprites_generated.h y el manifest de iconos color para
    retirar los assets huerfanos de Heal.
    Tests: applyHeal + "heal" como accion valida se eliminan de
    test_stats_engine y test_payload_validator (este ultimo anade caso
    negativo explicito).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
    [main.cpp, main_esp32.cpp]
2026-07-13 Feature: MessageBox con sanitizado UTF-8 a ASCII (core, host-testable)
    Buffer SPSC (post()/consume(), std::atomic<bool> sin mutex) para que el
    handler HTTP POST /api/v1/message (task async_tcp) entregue el texto del
    padre a loopTask sin bloquear el render. Incluye TextSanitizer::utf8ToAscii
    (transliteración Latin-1, descarte de ¿/¡/emoji/multibyte desconocido,
    colapso de espacios) ya que la fuente del renderer color es solo ASCII.
2026-07-13 Feature: logica pura de marquee (MarqueeLogic) con tests host
    Funciones puras (offsetPx, cyclePx, textX, passCount, firstVisibleChar) para
    el scroll horizontal del mensaje del padre, desacopladas del tiempo real
    (reciben elapsedMs por parámetro, igual que BatteryGauge/BootSplashLogic) y
    testeadas en host-native, incluidos casos límite de overflow con textos
    largos y velocidades altas.
    Desviación del plan: firstVisibleChar() añade `screenW` como parámetro
    explícito (offset, screenW, cycle, charW) en vez de los 3 pedidos
    (offset, cycle, charW) — cycle = textPxW + screenW mezcla ambas magnitudes
    por suma, así que screenW no es recuperable a partir de cycle a solas y es
    imprescindible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
2026-07-13 Feature: escena MessageView con marquee en DisplayRendererColor
    Nueva escena SceneColor::MessageView: HUD top + personaje (mood normal) +
    banda tipo bocadillo con el texto del padre en scroll horizontal. El scroll
    usa MarqueeLogic (por tiempo, no por frame) y solo dibuja la subcadena
    potencialmente visible para no imprimir chars con cursor muy negativo.
    showMessage()/dismissMessage()/messageActive() dan el control de ciclo de
    vida al caller (main_esp32.cpp); el forzado existente a DeadScreen si la
    mascota muere sigue pisando MessageView sin cambios.
2026-07-13 Feature: endpoint POST /api/v1/message en WebUI
    Nuevo endpoint sin acuse de recibo (200 al aceptar, no al mostrar): valida
    "text" (string requerida, tamaño crudo acotado a MessageBox::kMaxRawLen) y
    delega la sanitización/validación definitiva a MessageBox::post(). El 6º
    parámetro del ctor (MessageBox* = nullptr) mantiene src/main.cpp (ESP8266)
    compilando sin cambios — mountRoutes_ solo registra la ruta si se inyecta.
2026-07-13 Feature: integracion main_esp32 - consumo de mensajes y descarte por boton
    loop() consume MessageBox (SPSC) tras inputHandler->loop() y entra en
    SceneColor::MessageView solo si la mascota esta viva y la escena actual lo
    permite (IdleMain/StatsView/MessageView); recuerda la escena previa en
    sceneBeforeMessage_ para restaurarla cuando el marquee termina solo o se
    descarta por boton (click corto o pulsacion larga, via dismissMessage_()).
    El ctor de WebUI recibe &messageBox en ambas ramas de BATTERY_SENSE_ENABLED.
2026-07-13 Feature: panel Mensaje en dashboard web
    Añade el panel "Mensaje" al dashboard para enviar texto libre a
    POST /api/v1/message. Reutiliza section-title, .btn y el sistema de
    toast (flashFeedback) existentes; sigue el patrón de doReboot() en
    vez de doAction() porque la respuesta no es el estado del Tamagotchi.
2026-07-13 Docs: actualizar README con hito de mensajes + trabajo del 13 jul
2026-07-14 Feature: supervisor de red + recuperacion por eventos WiFi
    Cierra el hueco raiz del incidente de hoy (ping/mDNS vivos, puertos 80/3232
    con RST): WiFi.setAutoReconnect(true) reconecta a nivel bajo del driver y un
    blip mas corto que el polling de 500ms de WifiManager::loop() puede no ser
    visible, dejando WebUI/OTA con el socket muerto pero running_/ready_ en true
    (nunca se llamo a end()).
    - WifiManager registra WiFi.onEvent() para GOT_IP/STA_DISCONNECTED en ESP32.
    Los callbacks (task "arduino_events", no loopTask/async_tcp) solo escriben
    flags volatile -- nunca bus_.publish() directo (EventBus no es thread-safe).
    loop() consume esos flags en cada llamada (sin gate de 500ms) y hace el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
2026-07-14 Feature: Task Watchdog Timer + fix cuelgues fatales de setup
    - TWDT sobre loopTask (API antigua core 2.x/IDF4.4:
    esp_task_wdt_init(timeout_s, panic)). Se activa al final de setup(), tras
    los inits pesados, con WDT_TIMEOUT_S=10 (generoso: canvas->flush() SPI
    ~138KB + accesos LittleFS). esp_task_wdt_reset() como ultima linea de
    loop(). No se anade la task async_tcp (la gestiona la libreria; anadirla
    daria falsos positivos).
    - Los dos while(true){delay(5000);} de setup() (fallo TFT / fallo PSRAM)
    quedaban colgados para siempre sin recuperacion posible. Sustituidos por
    log + delay(2000) + ESP.restart() -- reintentar el boot es mejor que un
    cuelgue eterno que solo se arregla yendo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
    [main_esp32.cpp]
2026-07-14 Feature: watchdog de conectividad con anti-boot-loop
    - connectivityWatchdog_() en main_esp32.cpp (misma cadencia que el
    supervisor de red, NET_SUPERVISOR_INTERVAL_MS): si WiFi lleva caido mas de
    WIFI_DEAD_RESTART_MS (5 min) habiendo estado conectado antes
    (wifi.hasEverConnected()/lastConnectedMs(), ver commit anterior), persiste
    el estado (bus sincrono) y reinicia -- ultima linea de defensa cuando el
    re-begin idempotente del netSupervisor_ no basta. Sin conexion previa NUNCA
    reinicia por esto (router apagado desde el boot != fallo de firmware).
    - Nuevo modulo lib/infra/BootLoopGuard: contador anti-boot-loop en
    RTC_NOINIT_ATTR (sobrevive a ESP.restart(), se pierde en power-on-re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
2026-07-14 Feature: telemetria de uptime y reinicios en /api/v1/info
    - JsonCodec::serializeInfo() gana 3 campos: resetReason (string legible),
    bootCount (reinicios por WiFi caido, BootLoopGuard) y minFreeHeap (minimo
    historico de heap libre desde el boot). uptimeMs ya existia. Test nuevo
    (test_serialize_info_reset_telemetry_fields_present) + los 6 call sites
    existentes actualizados con los nuevos parametros.
    - WebUI::handleGetInfo_ los resuelve con la API nativa de cada plataforma:
    ESP32 -> esp_reset_reason()/BootLoopGuard::count()/
    esp_get_minimum_free_heap_size(); ESP8266 -> ESP.getResetReason() y
    bootCount/minFreeHeap=0 (features ESP32-only, mismo criterio "0 == no
    soportado en esta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
2026-07-14 Test: cobertura unitaria de la logica de decision de BootLoopGuard
    Extrae el contador y la comparacion contra BOOT_LOOP_MAX a
    BootLoopGuardLogic (sin RTC_NOINIT_ATTR ni esp_reset_reason), siguiendo
    el patron de BootSplashLogic/MarqueeLogic. El wrapper ESP32 delega en
    esa clase para no duplicar la decision; solo conserva la persistencia
    RTC y la deteccion cold-boot vs soft-reset.
    Cierra el gap detectado por QA: la logica de negocio de BootLoopGuard
    no tenia test unitario porque todo el modulo estaba bajo #ifndef
    UNIT_TEST y nunca compilaba en env:native.
2026-07-14 Fix: watchdog de conectividad medía mal el tiempo sin WiFi
    connectivityWatchdog_() reutilizaba WifiManager::lastConnectedMs()
    (instante de la ÚLTIMA conexión) como si fuera "instante de la caída".
    Con uptime > WIFI_DEAD_RESTART_MS (5 min), cualquier microcorte de WiFi
    disparaba un reinicio inmediato en vez de esperar 5 min de caída
    continua -- confirmado en campo (uptime ~5.4 min, corte de ~35 s,
    reinicio SW instantáneo).
    Se separa la semántica en un campo nuevo: WifiManager ahora trackea
    wifiDownSinceMs_ (instante de la PRIMERA pérdida de la racha actual,
    vía ConnectivityWatchdogLogic), sellado/limpiado en el mismo punto
    único de transición de estado que ya usa lastConnectedMs_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
    [config.h, main_esp32.cpp]
2026-07-14 Fix: alimentar el TWDT durante el OTA para que no aborte el flasheo
    ArduinoOTA.handle() bloquea el loopTask durante toda la recepción del
    binario (~940 KB, >10s), así que el esp_task_wdt_reset() del final de
    loop() nunca llega a ejecutarse durante un OTA y el TWDT (8ef8dce)
    reseteaba el chip a mitad de transferencia (confirmado en campo: dos
    OTA fallidos a 65%/78% con resetReason=TASK_WDT).
    onProgress_ corre síncronamente dentro de ArduinoOTA.handle(), en la
    misma pila que loop() -> ota.loop() -> ArduinoOTA.handle(), es decir
    en loopTask, la task suscrita al TWDT. Alimentarlo ahí en cada chunk
    (y una vez en onStart_ para el margen inicial) resuelve el bloqueo sin
    perder la protección: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
2026-07-14 Docs: actualizar README con hito de robustez de red y auto-recuperación (14 jul)
    - Changelog: supervisor de red (WiFi.onEvent), Task Watchdog Timer, watchdog
    de conectividad con anti-boot-loop, telemetría de reinicios, y los 2 bugs
    cazados en pruebas de hardware (timing del watchdog y TWDT abortando el OTA).
    - Tabla de estado + campos de GET /api/v1/info (resetReason/bootCount/minFreeHeap).
    - Conteo de tests host-native 171 -> 190 (nuevas suites BootLoopGuard y
    ConnectivityWatchdogLogic).
2026-07-14 Refactor: rename sleep→lights (action/evento/endpoint) + campos energy/lightsOn sin comportamiento
    Renombra mecánicamente ActionKind::Sleep→Lights, EventType::ActionSleepRequested→
    ActionLightsRequested, POST /api/v1/sleep→/api/v1/lights (handler, JsonCodec::
    parseSleepPayload→parseLightsPayload, PayloadValidator "sleep"→"lights") en toda
    la capa C++ (dominio, WebUI, renderers, orquestación ESP32/ESP8266) sin tocar
    comportamiento todavía: el toggle sigue gobernando isSleeping vía
    StatsEngine::applySleep (marcado TODO, se sustituye por applyLights en el
    siguiente commit).
    Añade los campos muertos Stats::energy/lightsOn, las 5 tasas de DecayRates y
    las constantes kEnergySleep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
2026-07-14 Feature: energía, auto-sueño/despertar y mecánica de luces en tick()
    Reescribe StatsEngine::tick(): la rama despierta drena energy a
    energyDrainPerSec y auto-duerme al llegar a kEnergySleepThreshold (≤20); la
    rama dormida se bifurca según lightsOn — luces apagadas regenera health
    (comportamiento legado) y recupera energy a tasa plena, luces encendidas
    penaliza happiness/health y recupera energy más lento (×
    energyRecoverLightsOnMul). Auto-despierta al llegar a kEnergyWakeThreshold
    (≥80) y fuerza lightsOn=true (amanece). Los acumuladores happiness/health/
    energy se resetean en cada transición dormido↔despierto porque cambian de
    semántica entre regímenes.
    Sustituye StatsEngin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
    [main.cpp, main_esp32.cpp]
2026-07-14 Test: energía, auto-sueño/despertar y penalización de luces
    Cubre la mecánica nueva de StatsEngine: drenaje de energy despierto,
    auto-sleep al cruzar kEnergySleepThreshold, auto-wake al cruzar
    kEnergyWakeThreshold (+ lightsOn forzado a true), lightsOn ralentiza la
    recuperación de energy (×energyRecoverLightsOnMul) y penaliza happiness/
    health mientras duerme, lightsOn=false regenera health como el
    comportamiento legado, applyLights() nunca toca isSleeping (despierto y
    dormido) y es no-op si el valor no cambia, listAvailableActions() mantiene
    Lights siempre visible mientras oculta Feed/Play dormido, y
    resetForNewLife() restaura energy=100/lightsOn=true.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
2026-07-14 Feature: schema persistencia v3 (energy+lightsOn) y migración v2→v3
    Sube kCurrentVersion a 3. Reinterpreta los 2 bytes [34..36) que en v2 eran
    `reservedV2b` como `energy` (uint8_t) + `reservedV3` (padding) — mismo
    tamaño y offsets, sizeof(PersistedState) sigue en 40 bytes (static_assert
    intacto). Documenta flags bit2=lightsOn.
    fillDefaults() fija energy=100, flags=0x04 (lightsOn=true). Nueva
    migrate_v2_to_v3_() fija energy=100 y hace OR de flags con 0x04 sin tocar
    isSick/isSleeping — imprescindible porque un blob v2 real tiene esos bytes
    a 0 (arrancaría agotado+a oscuras sin esta migración). migrate() encadena
    v1→v2→v3.
    Fix bug latente: migrate_v1_to_v2_ dejaba `version = kCu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
2026-07-15 Feature: exponer energy/lightsOn en /state + endpoint /lights
    JsonCodec::serializeState/serializeActionResponse añaden energy y lightsOn
    al bloque data (isSleeping se mantiene, ahora documentado como solo-lectura
    — ya no es controlable por el cliente). El endpoint POST /api/v1/lights
    (renombrado en el commit de refactor inicial) queda así con el contrato
    completo: GET /api/v1/state y las respuestas de acción exponen energy/
    lightsOn junto al resto de stats.
    applyToStatsEngine/fillFromEngine (ESP32-S3 y ESP8266) mapean el campo v3
    `energy` y el bit2 de `flags` (lightsOn) entre PersistedState y StatsEngine
    — antes de este commit el schema v3 persistía correctamente pero no llegaba
    a a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
    [main.cpp, main_esp32.cpp]
2026-07-15 Feature: pantalla oscura + zZZ con luces apagadas (color + mono)
    drawIdleMain_() (color y mono) añade un guard al inicio: isSleeping &&
    !lightsOn (descanso correcto, luces apagadas) renderiza drawLightsOffSleep_()
    — fondo negro con solo "zZZ" flotante (bob triangular vía animFrame_), sin
    HUD/iconos/sprite. NO toca TFT_BL ni ningún pin de backlight: lo que se
    apaga es el contenido, no el hardware. isSleeping && lightsOn (molesto, el
    usuario dejó la luz encendida) sigue el render normal (sprite
    MoodColor::Sleep + badge "Z", sin cambios — MVP).
    Etiquetas del HUD inferior para ActionKind::Lights pasan de WAKE/SLEEP
    (basadas en isSleeping) a LUCES OFF/LUCES ON en color y LUZ OFF/LUZ ON e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
2026-07-15 Docs: limpia TODO obsoleto en listAvailableActions (sleep→lights ya completado)
2026-07-15 Feature: dashboard — botón Luces, barra de energía y estado de sueño
    El sueño ahora lo decide el firmware según la nueva stat `energy`
    (POST /api/v1/sleep queda retirado), así que el botón manual pasa a
    controlar las luces de la habitación vía POST /api/v1/lights. Se añade
    la barra de energía reutilizando el mismo componente que hunger/happiness
    y se mantiene el badge de solo lectura "Sleeping" ya existente en
    pet-badges.
2026-07-15 Test: regresion — 'sleep' ya no es accion valida tras rename a lights
2026-07-15 Fix: mantener el menu de accion visible/operable en la pantalla de luces apagadas
    drawLightsOffSleep_() (color y mono) ahora dibuja el HUD inferior
    (drawHudBottom_ / drawActionHud_) sobre el fondo negro, tras el "zZZ" y
    antes de flush()/sendBuffer(). Sin esto, el usuario quedaba sin forma de
    ver ni seleccionar la acción "LUCES ON"/"LUZ ON" para reencender: la
    pantalla a oscuras ocultaba también el menú que la despierta. El resto
    (sprite, iconos de estado, HUD superior) sigue oculto — solo vuelve la
    barra de acciones.
2026-07-15 Fix: la accion 'Luces' solo aparece en el menu cuando la mascota duerme
    listAvailableActions() ocultaba Lights incondicionalmente disponible, pero
    solo tiene efecto visible dormido (la pantalla oscura exige isSleeping) —
    despierta, pulsarla cambiaba la etiqueta sin ningún efecto observable y
    parecía rota. Ahora Lights solo aparece cuando isSleeping, igual que
    Medicate depende de isSick.
    Invierte test_list_available_actions_lights_always_present (ahora
    test_list_available_actions_lights_only_when_sleeping): Lights ausente
    despierto, presente dormido.
2026-07-15 Feature: animacion de sueño con Zs flotantes que ascienden y se desvanecen
    Sustituye el "zZZ" estático con botecito por un rastro de 3 "z" que
    ascienden en diagonal (arriba-derecha) desde la zona de la cabeza del
    personaje, crecen y se desvanecen en bucle continuo — animación clásica de
    Zzz. Cada glifo recorre su propio ciclo escalonado (kZStagger frames
    respecto al anterior) para que siempre haya un rastro visible.
    Color (DisplayRendererColor): fase por tramos enteros sobre un periodo de
    30 frames — asciende (yOff), deriva a la derecha (xOff), crece (setTextSize
    1->2->3, 'z' minúscula -> 'Z' mayúscula) y se desvanece (color por quintos:
    COL_WHITE -> COL_CYAN -> COL_GRAY -> COL_DA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
2026-07-15 Docs: energia, auto-sueño y luces on/off (fiel 97) en el README
    Actualiza el recuento de tests (190 -> 203) en todas las referencias del
    documento. Refleja en la tabla "Estado actual" la nueva stat energy y la
    acción lights en StatsEngine, y la migración v1->v2->v3 en Persistence.
    Distingue explícitamente la fila diferida de gestión de energía de
    HARDWARE (Fase 5, auto-dim/modem sleep) de la mecánica de juego (energy),
    ya marcada como completada.
    Añade una sección breve "Energía, sueño automático y luces (fiel
    Tamagotchi 97)" explicando la mecánica: auto-sueño <=20/auto-despertar
    >=80, la acción Luces solo visible mientras duerme, penalización si se
    dejan encendidas y pantal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
2026-07-15 Fix: mantener WiFi y bateria visibles en la pantalla de luces apagadas
    drawLightsOffSleep_() (color y mono) ahora dibuja también los iconos de
    sistema sobre el fondo negro, junto al HUD inferior y antes de
    flush()/sendBuffer(): drawHudTop_() en color (WiFi + batería, esquinas
    superiores) y drawWifiIcon_() en mono (el ESP8266 no tiene batería). Sus
    propios guards existentes siguen aplicando (batería oculta si no es
    válida, blink de WiFi en Connecting, etc.) — sin necesidad de guard extra
    aquí.
2026-07-15 Feature: clase pura ScreenPowerLogic + tests para apagado de pantalla por inactividad
    Decide SLEEP/WAKE/NONE a partir de millis() inyectado, sin tocar hardware
    (mismo patrón que MarqueeLogic/ConnectivityWatchdogLogic). Los main*.cpp
    aplicarán el efecto físico en el siguiente commit.
2026-07-15 Feature: SCREEN_TIMEOUT_MS en config.h para apagado de pantalla por inactividad
    Wall-clock real (3 min), no escala con TURBO_MODE — mismo criterio que
    PERSIST_AUTOSAVE_MS.
2026-07-15 Feature: apagado de pantalla por inactividad en ESP32-S3 (backlight + panel JD9853)
    Integra ScreenPowerLogic en main_esp32.cpp: instancia global, helpers
    sleepScreen()/wakeScreen() (backlight TFT_BL + SLPIN/SLPOUT del panel),
    switch en loop() antes del render, y hooks noteInteraction() en botón
    (short/long press — primera pulsación con pantalla apagada solo despierta),
    en las 6 acciones HUD/HTTP y en el mensaje del padre. inhibitSleep=true
    mientras currentScene==OtaProgress para no apagar durante una actualización
    OTA visible. Render condicionado a screenPower.isScreenOn(); el decay/energía/
    LifeFSM siguen corriendo con la pantalla apagada.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
    [main_esp32.cpp]
2026-07-15 Feature: apagado de pantalla por inactividad en ESP8266 (OLED SSD1306)
    Integra ScreenPowerLogic en main.cpp: instancia global, helpers
    sleepScreen()/wakeScreen() (u8g2.setPowerSave), switch en loop() antes del
    render, y hooks noteInteraction() en botón (short/long press — primera
    pulsación con pantalla apagada solo despierta) y en las 6 acciones HUD/HTTP
    (el ESP8266 sí tiene WebUI con handlers de acción, a diferencia de lo
    asumido en el plan). inhibitSleep=true mientras currentScene==OtaProgress.
    Sin hook de mensaje del padre: el ESP8266 no consume MessageBox en su loop.
    Render condicionado a screenPower.isScreenOn(); el decay/energía/LifeFSM
    siguen corriendo con la pantalla apagada.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
    [main.cpp]
2026-07-15 Fix: OTA invisible con pantalla dormida + doble render en cada wake
    1) onOtaStarted no llamaba a screenPower.noteInteraction(): inhibitSleep
    solo impide apagar una pantalla ya encendida, no enciende una ya
    dormida. Un OTA lanzado tras >SCREEN_TIMEOUT_MS de inactividad dejaba
    la barra de progreso invisible indefinidamente. onOtaStarted corre en
    loopTask (vía ota.loop() -> ArduinoOTA.handle() -> onStart_, antes del
    switch de screenPower en el mismo loop()), así que el wake ya aplica
    en la misma vuelta.
    2) wakeScreen() forzaba un render() pero no actualizaba lastRenderMs,
    dejándolo obsoleto (~3 min) y provocando que el bloque de render
    programado repitiera el mismo f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
    [main.cpp, main_esp32.cpp]
2026-07-15 Fix: ralentizar animacion de sprites via SPRITE_ANIM_SLOWDOWN global
    Los sprites se movian demasiado rapido segun feedback de usuario. Se
    anade un factor unico y facil de tunear (SPRITE_ANIM_SLOWDOWN=2 en
    config.h) que ralentiza la cadencia de avance de frame en ambos
    renderers (color ESP32-S3 via msPerFrame, mono ESP8266 via
    kAnimTicksPerFrame derivado de ANIM_FRAME_MS), manteniendo paridad
    visual entre plataformas sin tocar fps por sprite en los manifiestos.
    [config.h]
2026-10-04 Feature: tabla de particiones 4MB con LittleFS 1.6MB
    default.csv deja 1.375MB de LittleFS y los 8 frames de la animacion jump
    del baby no caben (lfs_write error(-28): File system is full). La nueva
    tabla recorta los slots OTA a 2x1.125MB (firmware ~0.95MB) y amplia el
    LittleFS a 1.625MB, manteniendo nvs/otadata/coredump en su sitio.
    El primer flasheo con esta tabla debe ir por USB: la tabla de particiones
    no viaja por OTA y el LittleFS cambia de direccion.
    [esp32s3_4mb_ota_fs.csv]
2026-10-04 Feature: MoodLogic puro + tests
    Header puro lib/ui/MoodLogic/MoodLogic.h (sin Arduino, C++11) con
    MoodColor/kMoodCount (movidos desde DisplayRendererColor.h, nuevo
    Jump=5) y la logica de animacion one-shot:
    - moodForAction: Feed->Eat, Play->Jump, Medicate->Happy,
    Discipline->Sad, Clean->Idle; Lights/Stats sin one-shot.
    - fallbackMood/resolveMood: cadena Jump->Happy->Idle, Sleep->Idle.
    - actionAnimDurationMs: max(minMs, frames*(1000/fps)*slowdown).
    - oneShotFrameIndex: frame por tiempo desde el disparo, para que el
    one-shot empiece en el frame 0 y no derive con el FPS de render.
    23 tests Unity en test/test_mood_logic; -Ilib/ui/MoodLogic en env:native.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
2026-10-04 Feature: Play dispara jump en baby con fallback a happy
    - kSpriteLoad: el baby carga {idle,happy,sad,eat,sleep,jump}; el resto
    de etapas deja el slot Jump a nullptr.
    - framesForMood_ resuelve el mood con MoodLogic::resolveMood
    (Jump->Happy->Idle, Sleep->Idle).
    - triggerActionAnimation: mood via MoodLogic::moodForAction, resuelto
    contra la etapa para usar el count/fps reales; duracion
    actionAnimDurationMs(..., 1200) (salto 8f -> 2000 ms) compartida por el
    overlay de la pelota para que no desaparezca a mitad del salto.
    - drawSprite_: el frame del one-shot sale del tiempo transcurrido desde
    el disparo (oneShotFrameIndex), asi empieza en el frame 0 y el ultimo
    frame del salto no se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
    [main_esp32.cpp]
2026-10-04 Feature: assets jump furby-baby (RGB565) + manifest
    8 frames 48x48 RGB565 (4608 B c/u) de la animacion "jump" del baby,
    exportados con tools/export-esp32.mjs de Pixel Sprites (--folder baby,
    las 6 animaciones para que el upsert conserve la entrada completa).
    Los .bin de idle/happy/sad/eat/sleep salen byte-identicos; el manifest
    sigue con 17 sprites y el baby pasa a 6 animaciones.
    buildfs: cabe en el LittleFS de 1.625MB (367 de 416 bloques); con la
    tabla anterior de 1.375MB fallaba con "File system is full".
2026-10-04 Docs: README con tabla de particiones propia y animacion jump
    - Tabla de particiones 4MB: tamanos frente a default.csv, primer
    flasheo obligatorio por USB (la tabla no viaja por OTA) y aviso de que
    uploadfs borra el estado del pet (vuelve a Egg).
    - Animacion jump del baby: Play -> Jump con fallback Jump->Happy->Idle,
    duracion de 2 s, pelota sincronizada y comando de reexport con
    --folder baby y las 6 animaciones.
    - Recuento de tests (232, 16 suites) y arbol del proyecto actualizados.
2026-10-04 Feature: animaciones Kling del furby-baby (happy, eat, sad, sleep)
    Sustituye las animaciones happy (4→7 frames), eat (5→6), sad (4→6) y
    sleep (4→6) del bebé por las extraídas de vídeos de Kling con
    tools/video-to-sprite.mjs: mismo tamaño que idle, ojos sólidos (sin el
    bug de píxeles transparentes) y paleta ampliada (mofletes, galleta,
    lágrima). idle y jump no cambian. buildfs OK con la partición de 1,6 MB.
2026-10-04 Feature: NetInfoLogic puro para la pagina de red de Stats
    Header-only sin Arduino/WiFi (patron MoodLogic/ScreenPowerLogic):
    - statusFor()/statusLabel(): Conectado / Conectando... / Sin conexion /
    WiFi no configurada a partir de WifiState + SSID configurado.
    - fitText()/formatSsid()/formatHost(): texto ASCII imprimible truncado
    con "..." al ancho disponible; UTF-8 y controles se pintan como '?'.
    - formatIp() ("-" para 0.0.0.0), rssiToBars() 0-4 y formatRssi().
    - maxCharsForWidth() para la fuente base de Arduino_GFX (6 px/char).
    env:native: -Ilib/ui/NetInfoLogic y -Ilib/core (WifiState.h suelto).
2026-10-04 Test: 35 tests host de NetInfoLogic
    Estado por WifiState/SSID configurado, SSID vacio/null/17/32 chars,
    truncado con elipsis y corte seco, bytes UTF-8 y de control, buffers
    pequenos con canario, hostname .local, IP 0.0.0.0 y 255.255.255.255,
    RSSI en umbrales y extremos (-128, -1, 0, +127).
2026-10-04 Feature: WifiManager expone WifiInfo y loguea la IP al conectar
    - WifiInfo (lib/core/WifiState.h): instantanea sin dependencias de
    plataforma con estado, SSID configurado, SSID, hostname mDNS, IP y RSSI.
    Sin contrasenas por contrato.
    - WifiManager::info(): unico punto que traduce WiFi.* a WifiInfo; IP/RSSI
    en vivo solo si esta Connected. El renderer no toca WiFi.*.
    - publishState_(): en cada transicion A Connected imprime por serie
    "[wifi] Conectado a '<ssid>' IP=<ip> host=<host>.local" (antes la IP no
    se imprimia en ningun sitio pese a lo que decia platformio.ini).
2026-10-04 Feature: pagina de red (Stats 2/2) en DisplayRendererColor
    La pagina 1/2 de Stats ya llega a y~286 con bateria: no hay hueco para
    un bloque de red sin tapar nada ni pisar las esquinas curvas, asi que la
    red va en una segunda pagina (SceneColor::NetworkView, anadida al final
    del enum para no renumerar escenas):
    - LED + estado (Conectado / Conectando... / Sin conexion /
    WiFi no configurada), SSID, IP (cian, size 2), <host>.local y RSSI en
    dBm con 4 barras.
    - setWifiInfo(WifiInfo) formatea una vez con NetInfoLogic; el render solo
    imprime buffers (sin WiFi.* en la capa UI).
    - Cabecera (etapa+edad+WiFi) extraida a drawStatsHeader_() y titulo con
    indicador "1/2" / "2/2" en drawStatsTitle_(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
2026-10-04 Feature: navegacion Stats 1/2 -> Red 2/2 y refresco de WifiInfo
    - Click corto en StatsView pasa a NetworkView (refresco inmediato de
    WifiInfo); en NetworkView vuelve a IdleMain. Long press sigue sin efecto
    fuera de IdleMain. Los mensajes del padre tambien se muestran desde
    NetworkView y vuelven a ella al terminar.
    - refreshNetworkInfo_(): WifiManager::info() -> renderer->setWifiInfo().
    Se llama en cada WifiStateChanged, al entrar en la pagina y cada
    NET_INFO_REFRESH_MS (2 s, config.h) mientras esta visible.
    - Tras wifi.begin() se sincronizan icono y pagina con el estado real
    (Connecting/Disabled): begin() no publica WifiStateChanged y antes el
    icono seguia en Disabled hasta la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
2026-10-04 Docs: pagina RED de Stats, log de IP y flasheo OTA por IP
    - README: navegacion Stats 1/2 -> RED 2/2, mockup y tabla de campos,
    refresco, capas (WifiManager::info -> WifiInfo -> setWifiInfo ->
    NetInfoLogic), linea "[wifi] Conectado a ..." por serie y como flashear
    con --upload-port <IP> si tamagotchi.local no resuelve.
    - Contadores de tests 232 -> 267 (17 suites), arbol de directorios y
    changelog.
    - platformio.ini (esp32s3_ota): el comentario decia que la IP salia por
    serie al boot, pero no se imprimia en ningun sitio; ahora apunta a la
    pagina RED, al nuevo log y a --upload-port.
2026-10-04 Feature: growth cap en LifeFSM (tope de etapa por edad)
    Tope de crecimiento configurable en runtime (setGrowthCap) para pausar la
    evolucion en una etapa. Sin tope por defecto (kNoGrowthCap = Dead): el
    comportamiento original no cambia.
    Con tope:
    - no hay transicion por edad hacia una etapa > tope (ni muerte por vejez);
    - la edad se congela en (entrada a la etapa siguiente - 1), p.ej. 59 min en
    Baby, para que al quitar el tope no se salten etapas;
    - muerte por salud y resurreccion como Egg no cambian.
    restoreLifeState() carga etapa+edad desde Persistence de forma atomica: si
    la etapa guardada supera el tope (y no es Dead) la degrada al tope con la
    edad de entrada a esa etapa y resetea adu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
2026-10-04 Test: growth cap de LifeFSM (tope Baby, degradacion al cargar, turbo)
    22 tests nuevos: eclosion con tope, bloqueo de Baby -> Kid (por atencion y
    forzado a los 90 min), clamp de edad, sin muerte por vejez, muerte por salud
    y resurreccion intactas, degradacion de Kid/Adult/Old a Baby con
    age=kEggHatchMin, Dead intacto, regresion sin tope y tope con factor turbo 60.
2026-10-04 Feature: campo growthCap en /api/v1/state y respuestas de accion
    data.growthCap expone la etapa tope de la pausa de crecimiento con el mismo
    formato que lifeStage ("Baby") o null si no hay tope. Campo aditivo y siempre
    presente: backward compatible dentro de v1.
    JsonCodec::serializeState/serializeActionResponse reciben el nombre del tope
    (nullptr -> null); WebUI lo obtiene de LifeFSM via growthCapName_(). Se
    actualizan los call sites de los tests y se anaden 3 tests (null sin tope,
    formato de etapa, respuesta de accion).
2026-10-04 Feature: GROWTH_CAP_STAGE opcional y aplicacion en el boot de main_esp32
    config.h: GROWTH_CAP_STAGE opcional (#ifndef -> GROWTH_CAP_ENABLED 0), con
    el porque de la pausa. main_esp32.cpp:
    - static_assert de rango (Egg..Old) donde LifeStage es visible;
    - setGrowthCap() ANTES de cargar Persistence + log "[life] growth cap
    activo: Baby";
    - carga con restoreLifeState() en vez de setStage/setAgeMinutes: si la etapa
    guardada supera el tope se degrada (LOG_WARN con etapa/edad antes y
    despues) y, tras suscribir los handlers, se fuerza un PersistRequested;
    - el renderer recibe la edad de LifeFSM (ya degradada), no la de flash.
    Sin el define el comportamiento es identico al anterior.
    Co-Authore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
2026-10-04 Feature: pausa de crecimiento en Baby para esp32s3 (GROWTH_CAP_STAGE=1)
    Solo el bebe tiene las animaciones nuevas (Kling): [env:esp32s3] anade
    -D GROWTH_CAP_STAGE=1 a build_flags, heredado por esp32s3_turbo y
    esp32s3_ota. El pet guardado como Adult vuelve a Baby al arrancar con sus
    stats. esp12e no lo lleva. Quitar la linea para que vuelva a evolucionar.
2026-10-04 Docs: pausa de crecimiento en Baby (que es y como quitarla)
    Nueva seccion en la variante ESP32-S3: comportamiento del tope, degradacion
    de pets ya crecidos conservando stats, logs esperados, campo growthCap de la
    API, donde se configura y como quitarla. Tabla de API, changelog y contador
    de tests (267 -> 292) actualizados.
2026-11-02 Docs: README con botón táctil TTP223 en GPIO4, licencia y guía de montaje
2026-11-02 Fix: fijar espressif32@6.10.0 en esp32s3 (core 2.0.17 para Arduino_GFX 1.3.7)
2026-11-02 Fix: quitar el puerto USB del Mac de platformio.ini y documentar --upload-port
2026-11-02 Security: quitar IP de la LAN, contraseña por defecto y rutas locales
    - integration_test.sh: AUTH_PASS ya no tiene valor por defecto; sin ella el
    script sale con error. Ejemplos con 192.168.x.x y tu_pass.
    - README: fuera las rutas a ~/.claude y ~/Tamagochi.
